Samad-Simprints/Vero-Firmware/README.md

# Scanner-Code
The Simprints Scanner Code
