Samad-Simprints/Vero-Firmware/hw/scanner/schematic/scanner_revB.xlsx

Top Level Revised: Tuesday, May 31, 2016
Index Scanner Iss 2 Revision: B
Fen Technology Ltd
Oakington Business Park
Oakington
Cambridge
CB24 3DQ
Bill Of Materials June 5,2016 17:37:55 | Page1
Item | Quantity | Reference | Part | Footprint | Manufacturer | Manufacturer's Part Number | Supplier | Supplier Part Number
______________________________________________
1 | 16 | C1,C2,C3,C4,C10,C14,C15, | 27pF/50V | 402 | Phycomp | CC0402JRNPO9BN270 | Farnell | 1816735
 |  | C32,C33,C34,C35,C36,C50,
 |  | C61,C62,C64
2 | 8 | C5,C6,C7,C8,C11,C12,C37, | 2.2uF, X5R | 402 | TDK | C1005X5R0J225K050BC | Farnell | 2346873
 |  | C39
3 | 29 | C9,C13,C16,C20,C21,C22, | 100nF/50V | 402 | TDK | CGA2B3X7R1H104K050 | Farnell | 2210822
 |  | C23,C24,C25,C26,C27,C28,
 |  | C29,C38,C40,C41,C42,C44,
 |  | C48,C52,C53,C54,C56,C57,
 |  | C59,C60,C63,C66,C69
4 | 1 | C17 | 10nF/50V | 402 | TDK | CGA2B3X7R1H103K050 | Farnell | 2210821
5 | 3 | C18,C67,C68 | 1nF/50V | 402 | TDK | CGA2B2X7R1H102K050BA | Farnell | 2210796
6 | 6 | C19,C46,C47,C55,C58,C65 | 10uF | 805 | TDK | C2012X5R0J106M | Farnell | 2309029
7 | 1 | C45 | 10nF/500V | 805 | Yageo | CC0805KKX7RBBB103 | Farnell | 1284130
8 | 2 | C49,C51 | 22uF | 805 | Taiyo Yuden | JMK212BJ226KG-T | Farnell | 2113069
9 | 1 | C70 | 1uF | 402 | multicomp | MC0402X105K6R3CT | Farnell | 1759375
10 | 1 | D1 | BLUE | LED_WURTH_WL-SMTW-150141BS73100 | Wurth | 150141BS73100 | Farnell | 2322105
11 | 6 | D2,D3,D4,D5,D6,D7 | WE-150141RV73100 | LED_WURTH_WL-SBTW-150141RV73100 | Wurth | 150141RV73100 | Farnell | 2322113
12 | 2 | D13,D15 | 1N4148W | SOD-123 | MULTICOMP | 1N4148W | Farnell | 1621821
13 | 4 | FB1,FB2,FB3,FB4 | 7427927291 | 402 | Wurth Elektronik | 7427927291 | Farnell | 1961694
14 | 1 | J1 | TC2050_IDC | TC2050IDC-NL | Tag_connect | TC2050IDC-NL | NA | NA
15 | 1 | J2 | Molex 12W FFC 0.5mm | CONN_MOLEX_52746-12WAY | Molex | 52746-1271 | Farnell | 2060699
16 | 1 | J3 | 1054431101 | CONN_USB-AB_MOLEXWP_SD105443-110_0.65P | Molex | 1054431101 | Farnell | 2500017
17 | 1 | J4 | 53261-0371 | CONN_MOLEX_53261-3WAY_RA | Molex | 53261-0371 | Farnell | 1125359
18 | 1 | L1 | 600R/1A | 742792651 | Wurth Elektronik | 742792651 | Farnell | 1635706
19 | 2 | L2,L5 | 744231091 | 744231091 | Wurth Elektronik | 744231091 | Farnell | 1636469
20 | 4 | L3,L4,L6,L9 | WE-CBF_742792651 | WE-CBF_742792651 | Wurth | 742792651 | Farnell | 1635706
21 | 1 | L7 | 3.3uH/0.65A | IND_744030003 | Wurth | 744030003 | Farnell | 2211437
22 | 1 | L8 | 3.3uH/2A | IND_COILCRAFT_LPS4018_3.9X3.9_1.8H | Coilcraft | LPS4018-332MRC | Mouser | 994-LPS4018-332MRC
23 | 1 | Q1 | FDC6420 | SOT23-6L | Fairchild | FDC6420C | RS | 903-4147
24 | 1 | Q2 | IRLML0030TRPBF | SOT23-132 | IR | IRLML0030TRPBF | Farnell | 1791366
25 | 2 | Q3,Q11 | BC857C | SOT23-132 | NXP | BC857C | Farnell | 8734771
26 | 7 | Q4,Q5,Q6,Q7,Q8,Q9,Q10 | MUN5211DW | SOT363 | On Semi | MUN5211DW1T1G | Farnell | 2317633
27 | 1 | R1 | 15R | 603 | Yageo | RC0603JR-0715RL | Farnell | 9233156
28 | 11 | R3,R5,R15,R35,R75,R79, | 100K | 402 | Multicomp | MC 0.0625W 0402 1% 100K | Farnell | 1358096
 |  | R80,R82,R102,R106,R107
29 | 25 | R6,R8,R10,R16,R18,R19, | 10K | 402 | Multicomp | MC 0.0625W 0402 1% 10K | Farnell | 1358069
 |  | R21,R22,R23,R24,R26,R29,
 |  | R30,R40,R43,R44,R45,R46,
 |  | R49,R59,R78,R101,R104,
 |  | R105,R110
30 | 2 | R11,R12 | 2K2 | 402 | Multicomp | MC 0.0625W 0402 1% 2K2 | Farnell | 1358051
31 | 1 | R13 | 12K | 402 | Multicomp | MC 0.0625W 0402 1% 12K | Farnell | 1358071
32 | 2 | R14,R77 | 1K5 | 402 | Multicomp | MC 0.0625W 0402 1% 1K5 | Farnell | 1358047
33 | 5 | R17,R20,R27,R97,R98 | 22R | 402 | Multicomp | MC 0.0625W 0402 1% 22R | Farnell | 1357998
34 | 1 | R28 | 0.01R | 603 | Vishay Dale | WSL0603R0100FEA | Farnell | 2112794
35 | 5 | R31,R32,R99,R100,R108 | 15K | 402 | Multicomp | MC 0.0625W 0402 1% 15K | Farnell |  | 1358073
36 | 3 | R33,R39,R50 | DNF | 402
37 | 1 | R34 | 1M/400V | 805 | Welwyn | LHVC0805-1MFT5 | Farnell | 1506149
38 | 2 | R36,R81 | 332K | 402 | Multicomp | MC 0.0625W 0402 1% 332K | Farnell | 1803798
39 | 1 | R37 | 75K | 402 | Multicomp | MC 0.0625W 0402 1% 75K | Farnell | 1358093
40 | 1 | R38 | 6K2 | 402 | Multicomp | MC 0.0625W 0402 1% 6K2 | Farnell | 1358063
41 | 4 | R41,R42,R51,R52 | 1M | 402 | Multicomp | MC 0.0625W 0402 1% 1M | Farnell | 1358123
42 | 1 | R47 | 3K3 | 402 | Multicomp | MC 0.0625W 0402 1% 3K3 | Farnell | 2130392
43 | 1 | R48 | 2K | 402 | Multicomp | MC 0.0625W 0402 1% 2K | Farnell | 1358050
44 | 12 | R53,R54,R55,R56,R57,R58, | 56R | 603 | Multicomp | MC 0.0625W 0603 1% 56R | Farnell | 9331387
 |  | R60,R61,R62,R63,R65,R66
45 | 2 | R76,R103 | 470R | 402 | Multicomp | MC 0.0625W 0402 1% 470R | Farnell | 1358034
46 | 1 | R109 | 33K | 402 | Multicomp | MC 0.0625W 0402 1% 33K | Farnell |  | 2130474
47 | 1 | SW1 | MCDHN-02F-V | SW_MULTICOMP_MCDHN_2WAY_3.8X4.5 | Multicomp |  | Farnell
48 | 2 | S1,S2 | SKRAALE010 | SW_ALPS_SKRAALE010_6.2X6.2_3.4H | ALPS | SKRAALE010 | Farnell | 2056845
49 | 30 | TPVIA2,TPVIA6,TPVIA7, | TPVIA | TPVIA
 |  | TPVIA8,TPVIA9,TPVIA10,
 |  | TPVIA11,TPVIA12,TPVIA13,
 |  | TPVIA14,TPVIA15,TPVIA16,
 |  | TPVIA17,TPVIA18,TPVIA19,
 |  | TPVIA20,TPVIA21,TPVIA22,
 |  | TPVIA23,TPVIA24,TPVIA25,
 |  | TPVIA26,TPVIA27,TPVIA28,
 |  | TPVIA29,TPVIA30,TPVIA31,
 |  | TPVIA32,TPVIA33,TPVIA34
50 | 17 | TP1,TP2,TP3,TP4,TP5,TP6, | TP_DFM_NOFILL | TP_DFM
 |  | TP7,TP8,TP9,TP10,TP11,
 |  | TP12,TP13,TP14,TP15,TP16,
 |  | TP17
51 | 1 | U1 | BTM805CL2B | MODULE_FLAIRCOMM-FLCBTM805 | FlairMicro | BTM805CL2B | BCD | BTM805CL2B
52 | 1 | U2 | LPC1833_LBGA256 | BGA256C100P16X16_1700X1700X155 | NXP | LPC1833JET256 | DigiKey | LPC1833JET256,551-ND
53 | 1 | U3 | STM809RWX6F | SOT23-132 | ST Microelectronics | STM809RWX6F | Farnell | 8690413
54 | 1 | U4 | AT45DB161E-SSHD-B | SOIC8 | Adesto | AT45DB161E-SSHD-B | Farnell | 2136671
55 | 1 | U5 | SN74LVC1G74DCU | SO8_2.0X2.4_0.5 | TI | SN74LVC1G74DCU | Farnell | 2295725
56 | 1 | U6 | MIC94093YC6 | SC70-6 | Microchip | MIC94093YC6 | Mouser | 998-MIC94093YC6TR
57 | 1 | U7 | 82400102 | SOT23-6L | Wurth Elektronik | 82400102 | Farnell | 1825875
58 | 1 | U8 | LTC3542EDC | DFN_6_2X2_SLUG | Linear Tech | LTC3542EDC | Farnell | 1715237
59 | 1 | U9 | LTC4160 | QFN20_3X4_WITH_SLUG_0.75H | Linear Tech | LTC4160EUDC | DigiKey | LTC4160EUDC#PBF-ND
60 | 1 | U10 | SN74LVC1G06DBVR | SOT23-5 | TI | SN74LVC1G06DBVR | Farnell | 1105928
61 | 2 | U11,U14 | TS3USB221EDRCR | QFN10_3X3_0.5_SLUG | TI | TS3USB221EDRCR | Farnell | 2383155
62 | 1 | U12 | LTC2941CDCB | DFN_6_2X3_SLUG | Linear Tech | LTC2941CDCB#TRMPBF | DigiKey | LTC2941CDCB#TRMPBFCT-ND
63 | 1 | VIB1 | DNF | VIBRO_JINLONG_C1027H300F | Jinlong | C1027H300F | ?
64 | 1 | Y1 | 12.00MHz | TXC_2.5X3.2 | TXC | 7M-12.000MAAJ-T | Farnell | 1842056
