Samad-Simprints/Vero-Firmware/fw/installation/README.md

# Manufacturing-LPC-Script
A collection of scripts that will be used in the manufacture of Simprints fingerprint scanners (SFS).
