Samad-Simprints/Vero-Firmware/hw/scanner/schematic/scanner_revc.pdf

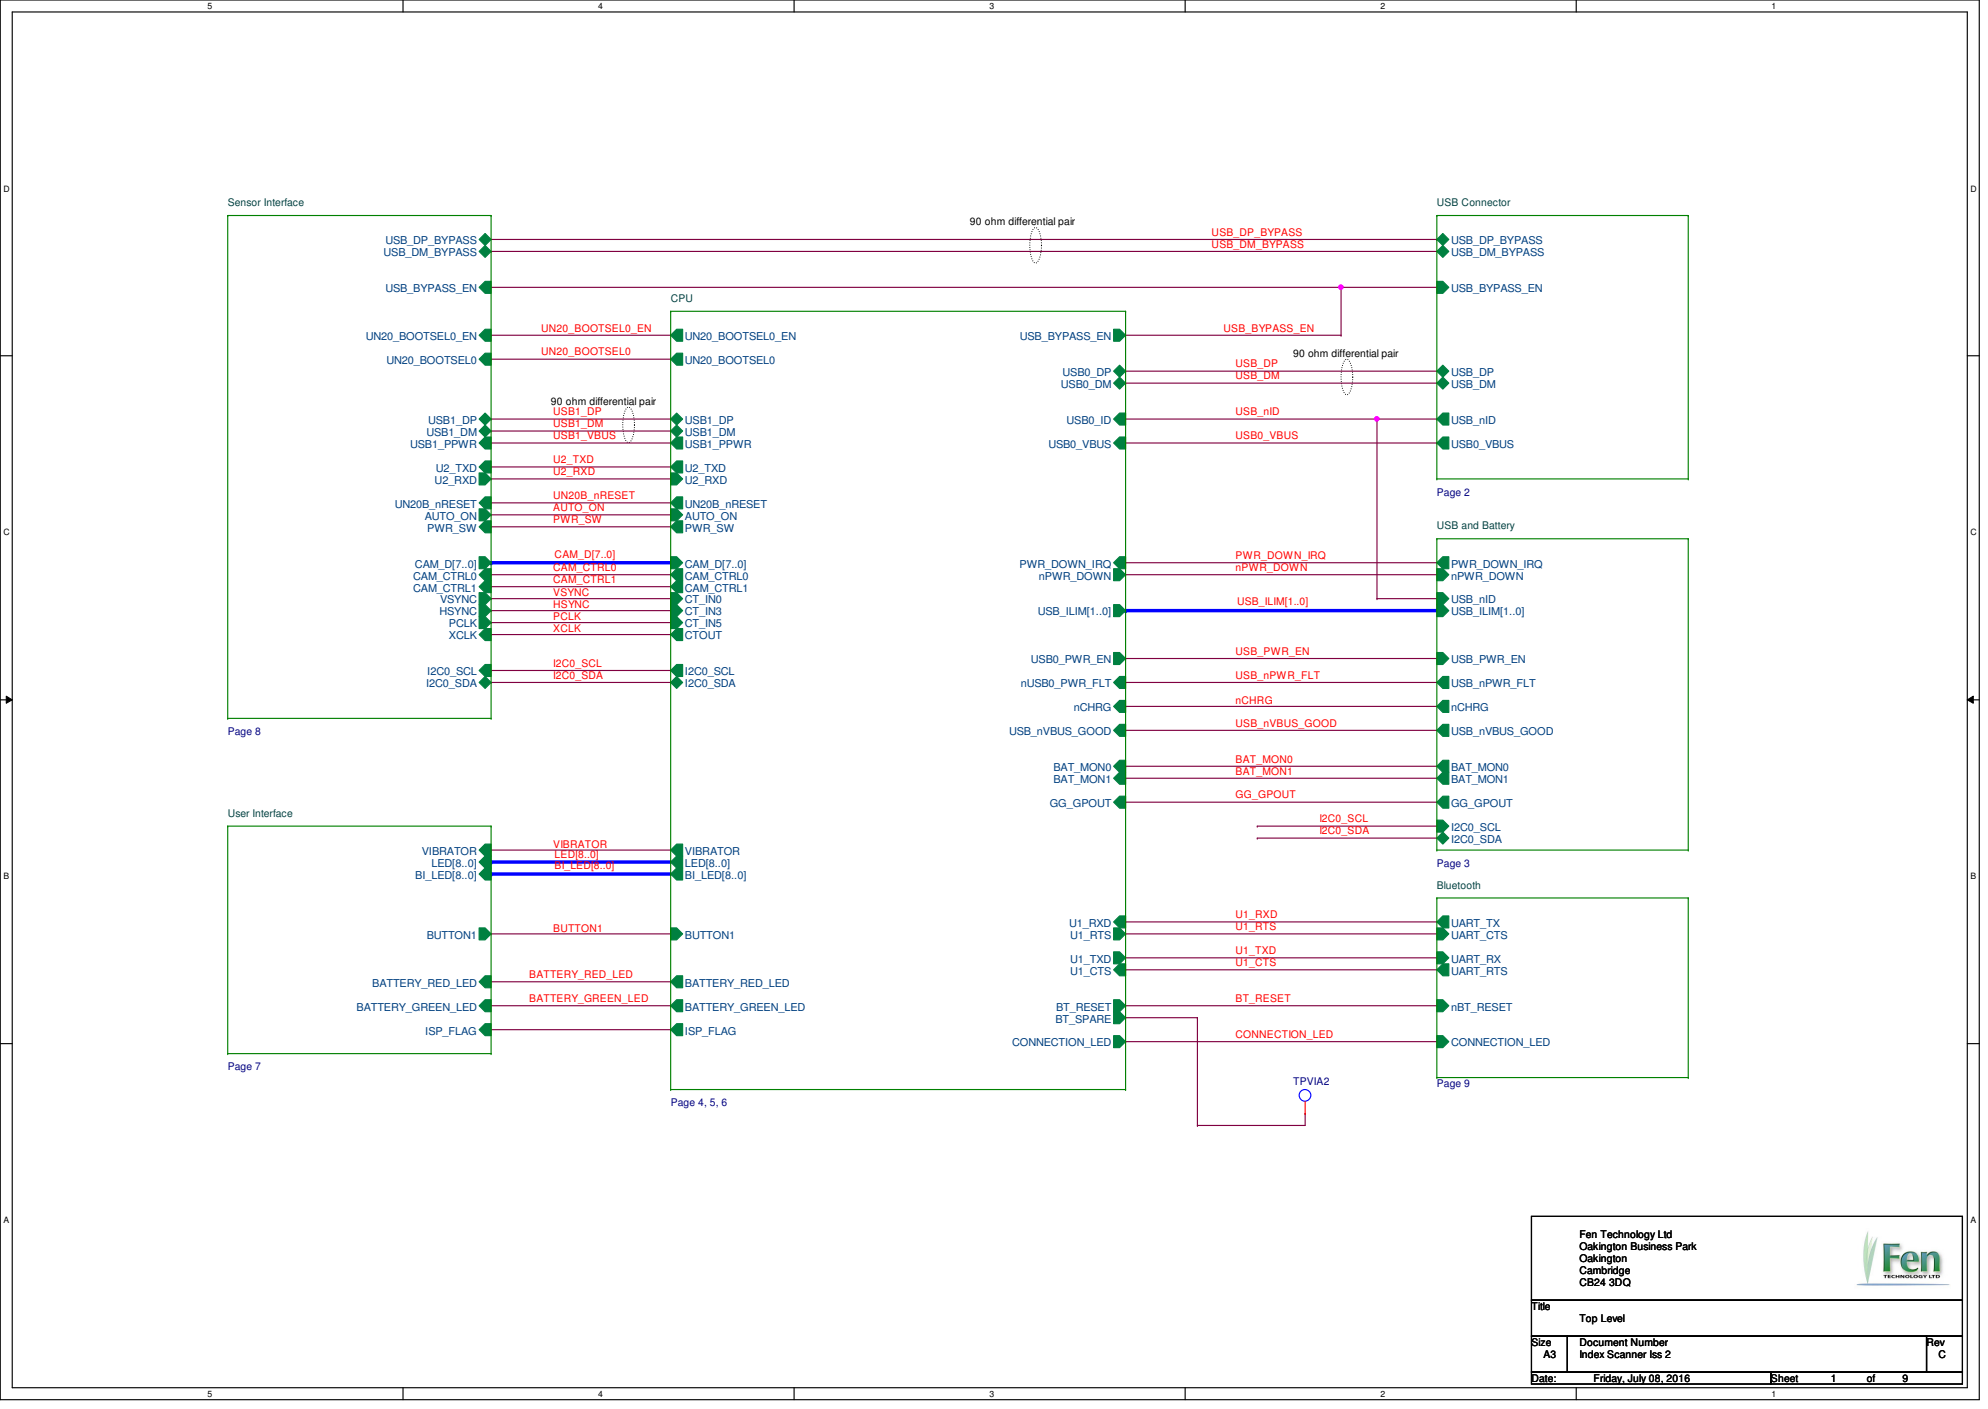
[picture p1: page 1]
90 ohm differential pair; U1_RXD U1_RTS; U1_TXD U1_CTS; BT_RESET; USB1_DP USB1_DM USB1_VBUS; U2_TXD U2_RXD; UN20B_nRESET AUTO_ON PWR_SW; CAM_D[7..0]; VSYNC HSYNC PCLK XCLK; I2C0_SCL I2C0_SDA; LED[8..0]; VIBRATOR; BUTTON1; BI_LED[8..0]; CONNECTION_LED; BATTERY_RED_LED; USB_DM; USB_DP; USB_nID; PWR_DOWN_IRQ; BAT_MON0 BAT_MON1; USB_nPWR_FLT; USB_nVBUS_GOOD; USB_PWR_EN; USB0_VBUS; nCHRG; UN20_BOOTSEL0_EN; UN20_BOOTSEL0; USB_BYPASS_EN; USB_DP_BYPASS USB_DM_BYPASS; BATTERY_GREEN_LED; GG_GPOUT; Title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

90 ohm differential pair

USB and Battery

CAM_CTRL0 | nPWR_DOWN
CAM_CTRL1 | USB_ILIM[1..0]

Fen Technology Ltd
Oakington Business Park
Oakington
Cambridge

## UART_TX

## UART_RX

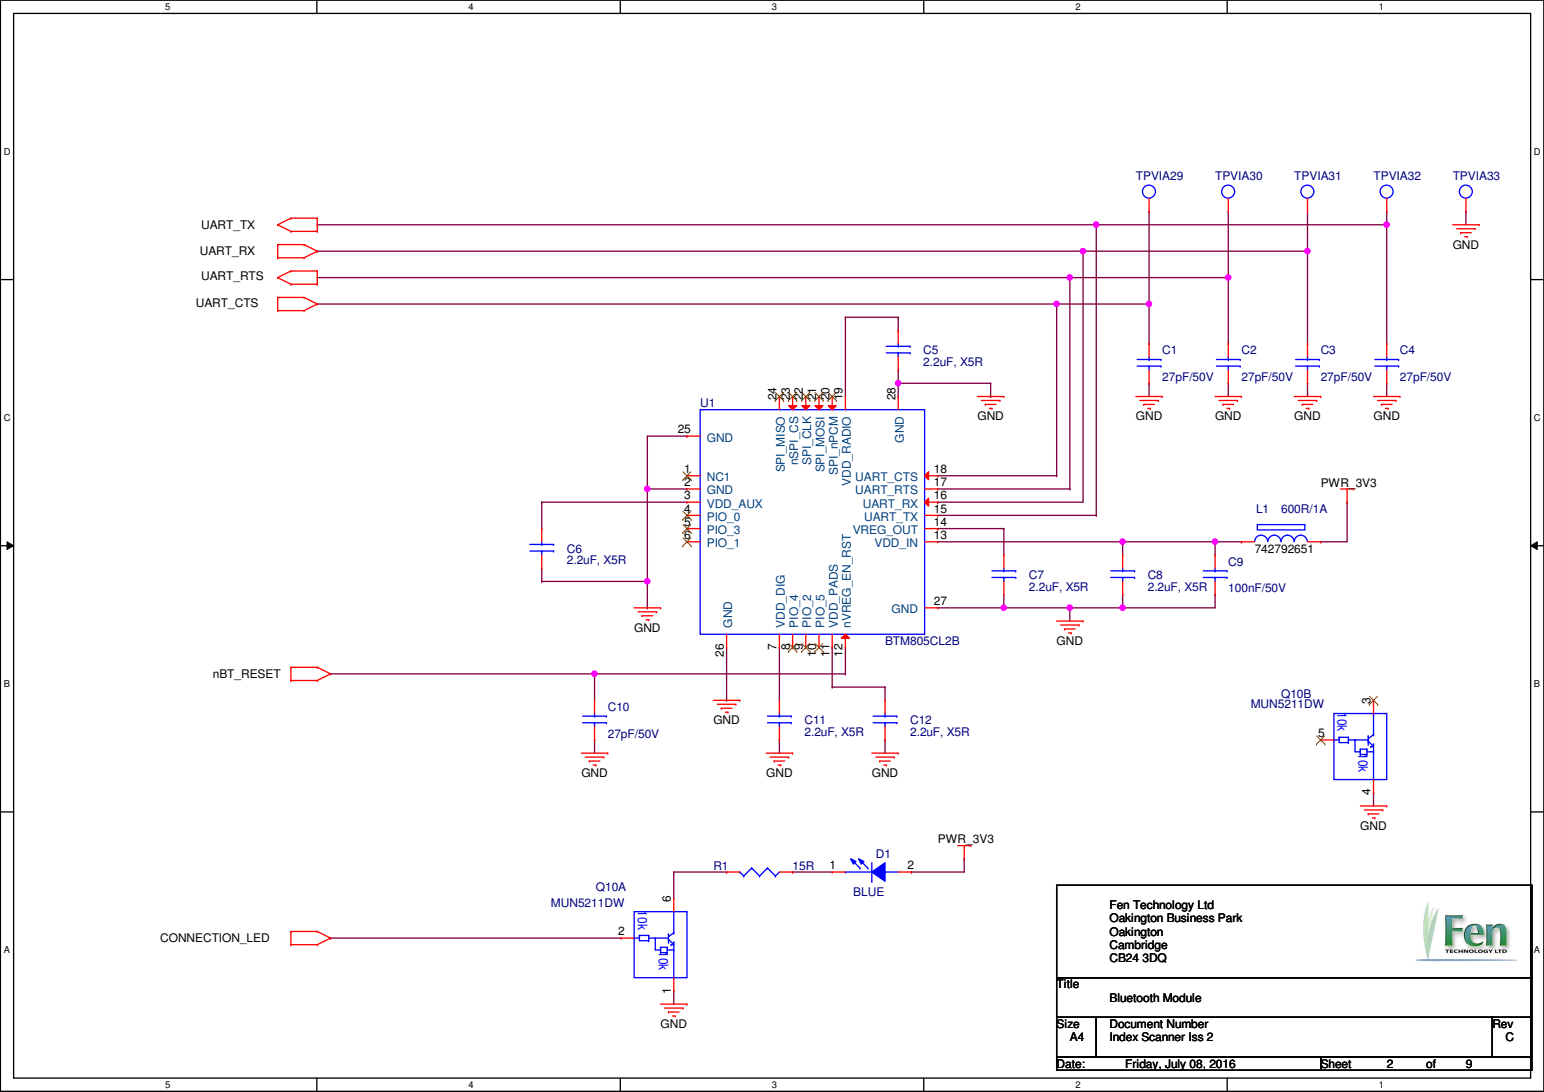
[picture p2: page 2]

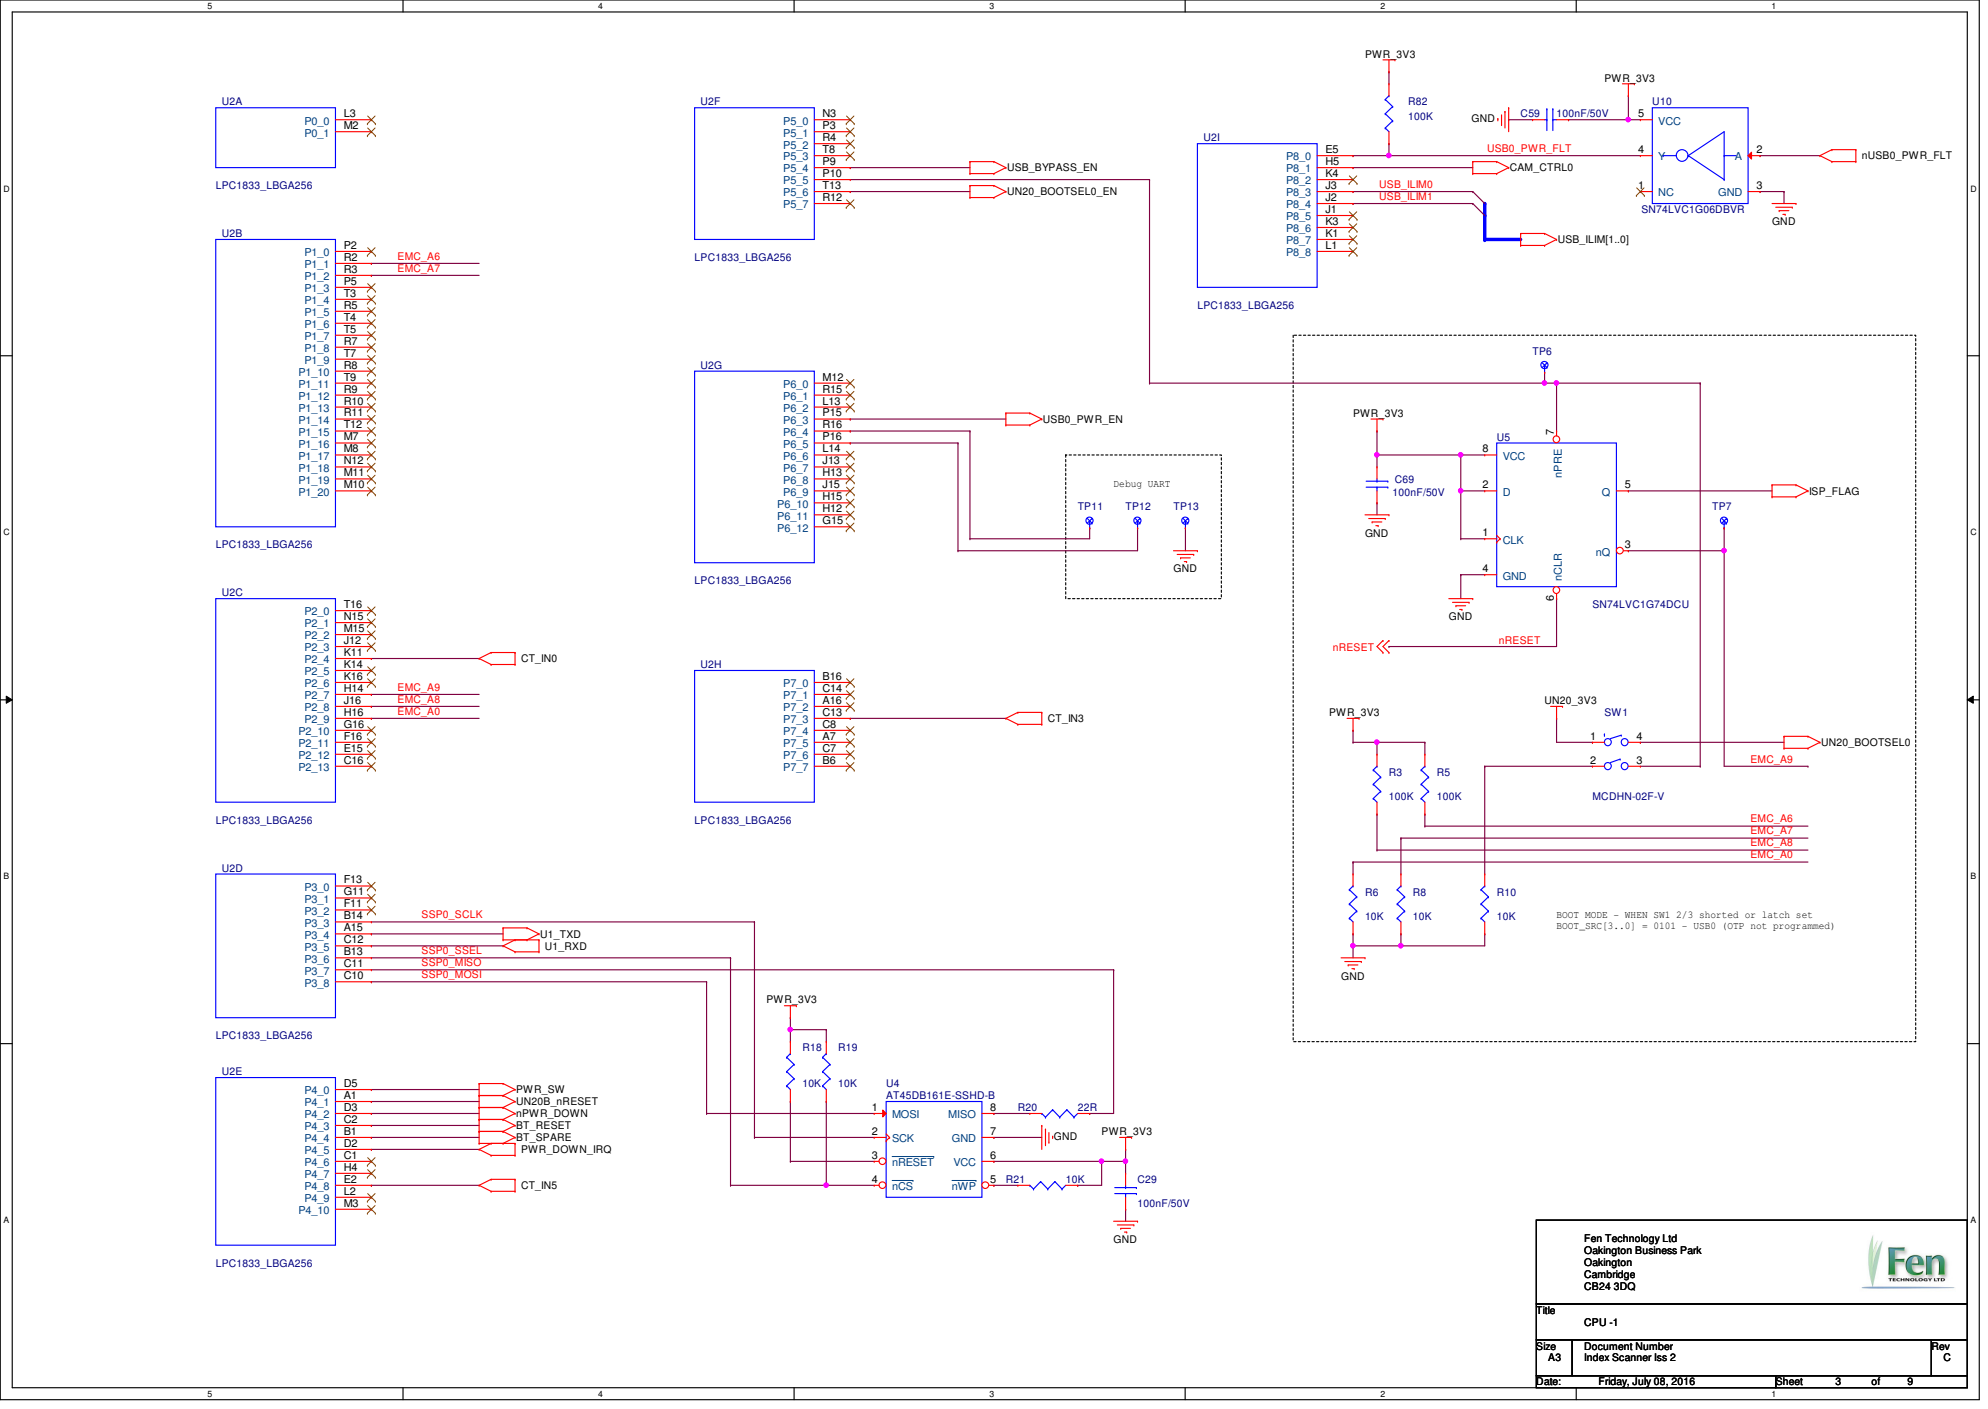
[picture p3: page 3]

BOOT MODE - WHEN SW1 2/3 shorted or latch set
BOOT_SRC[3..0] = 0101 - USB0 (OTP not programmed)

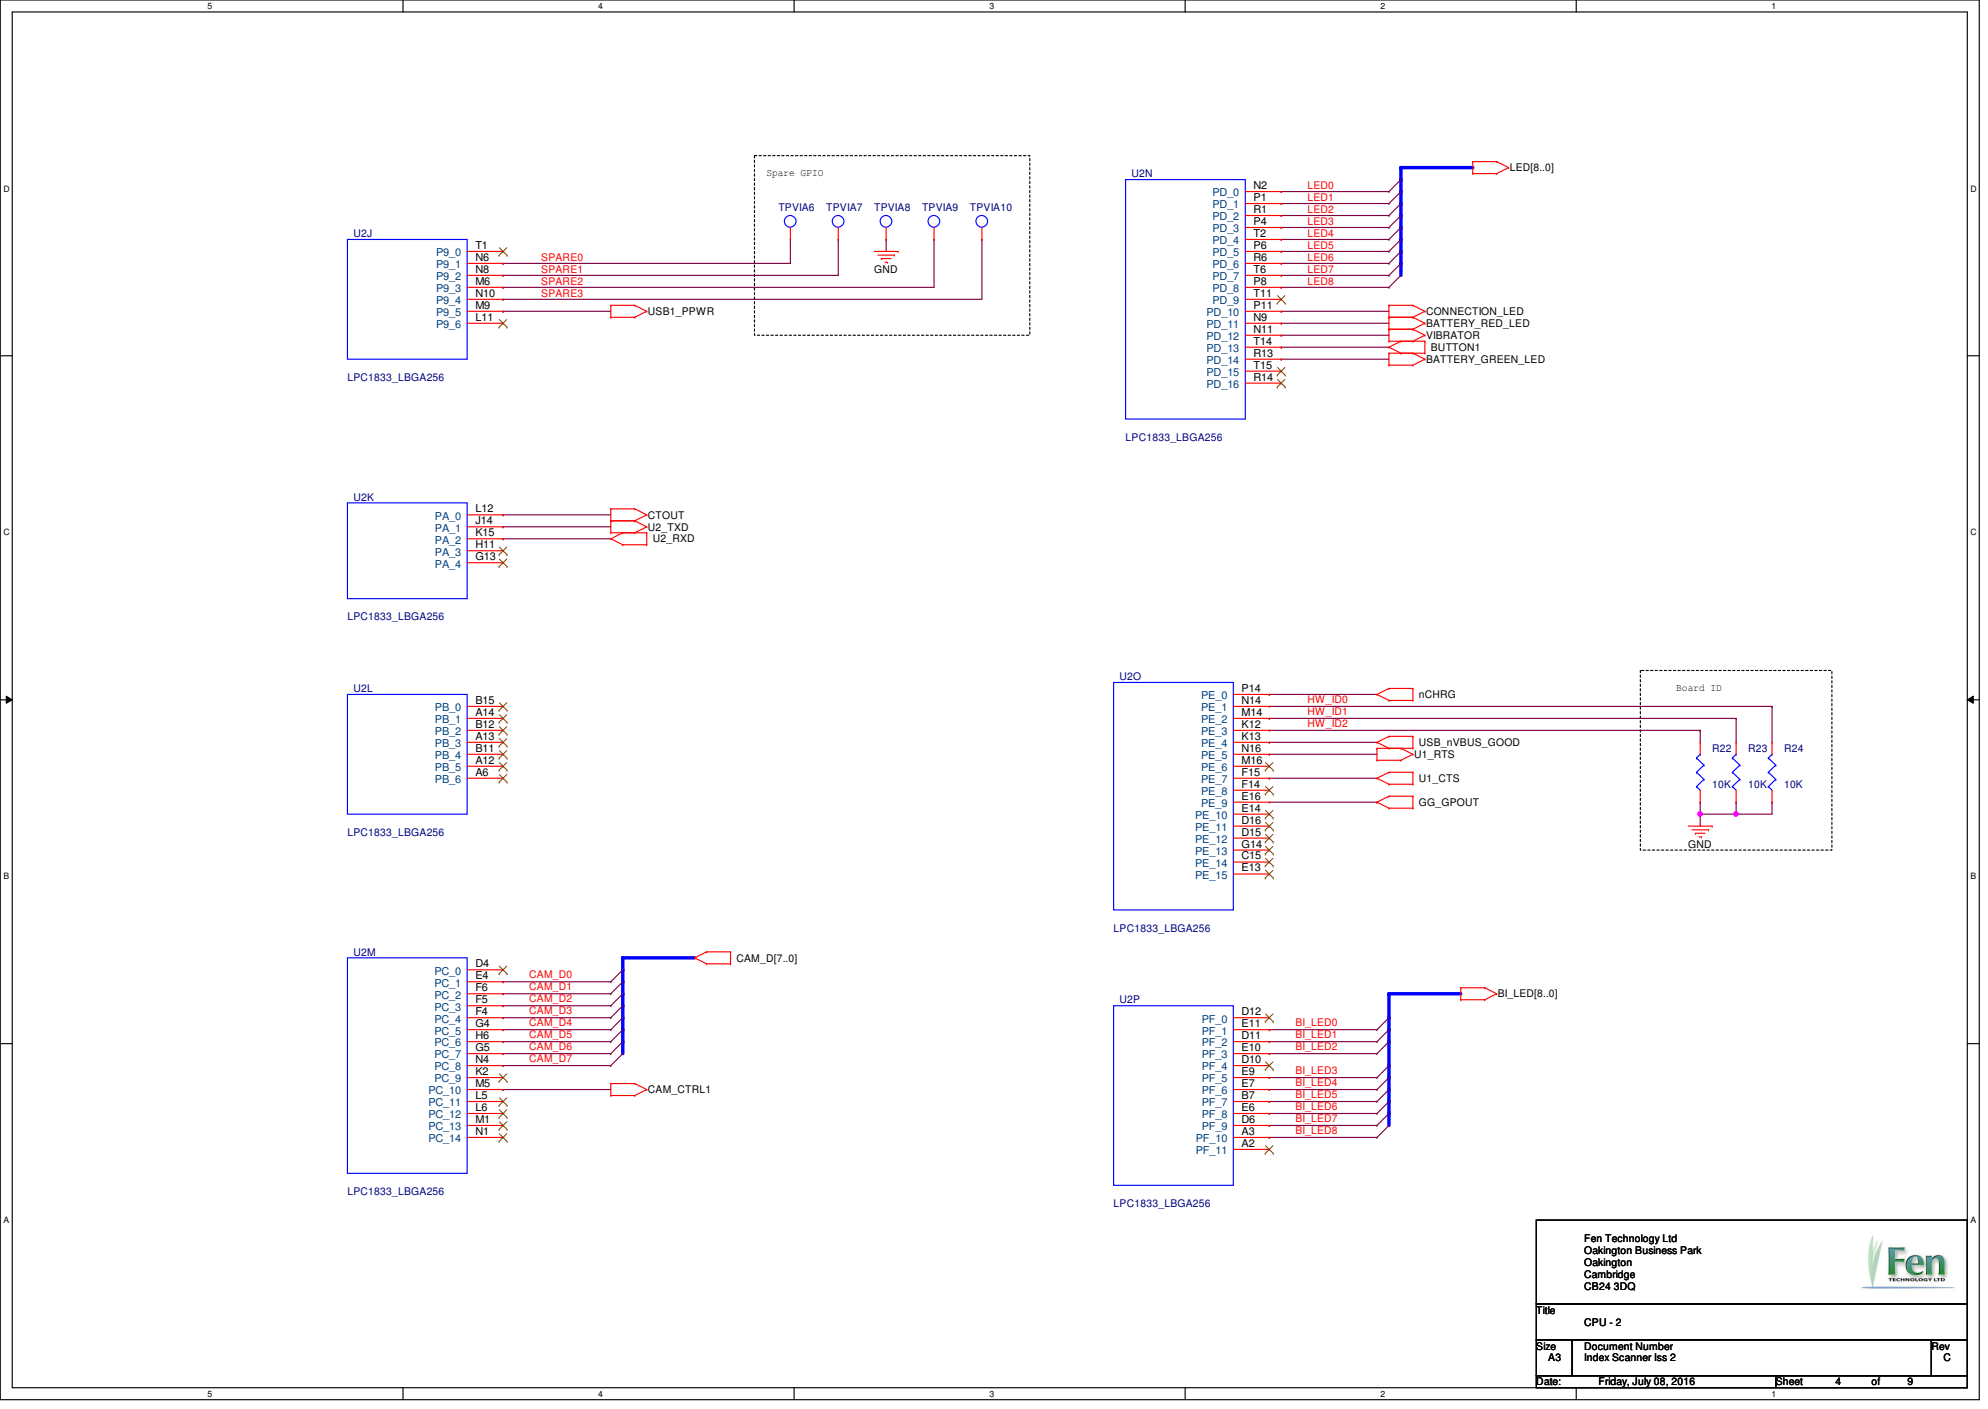
[picture p4: page 4]

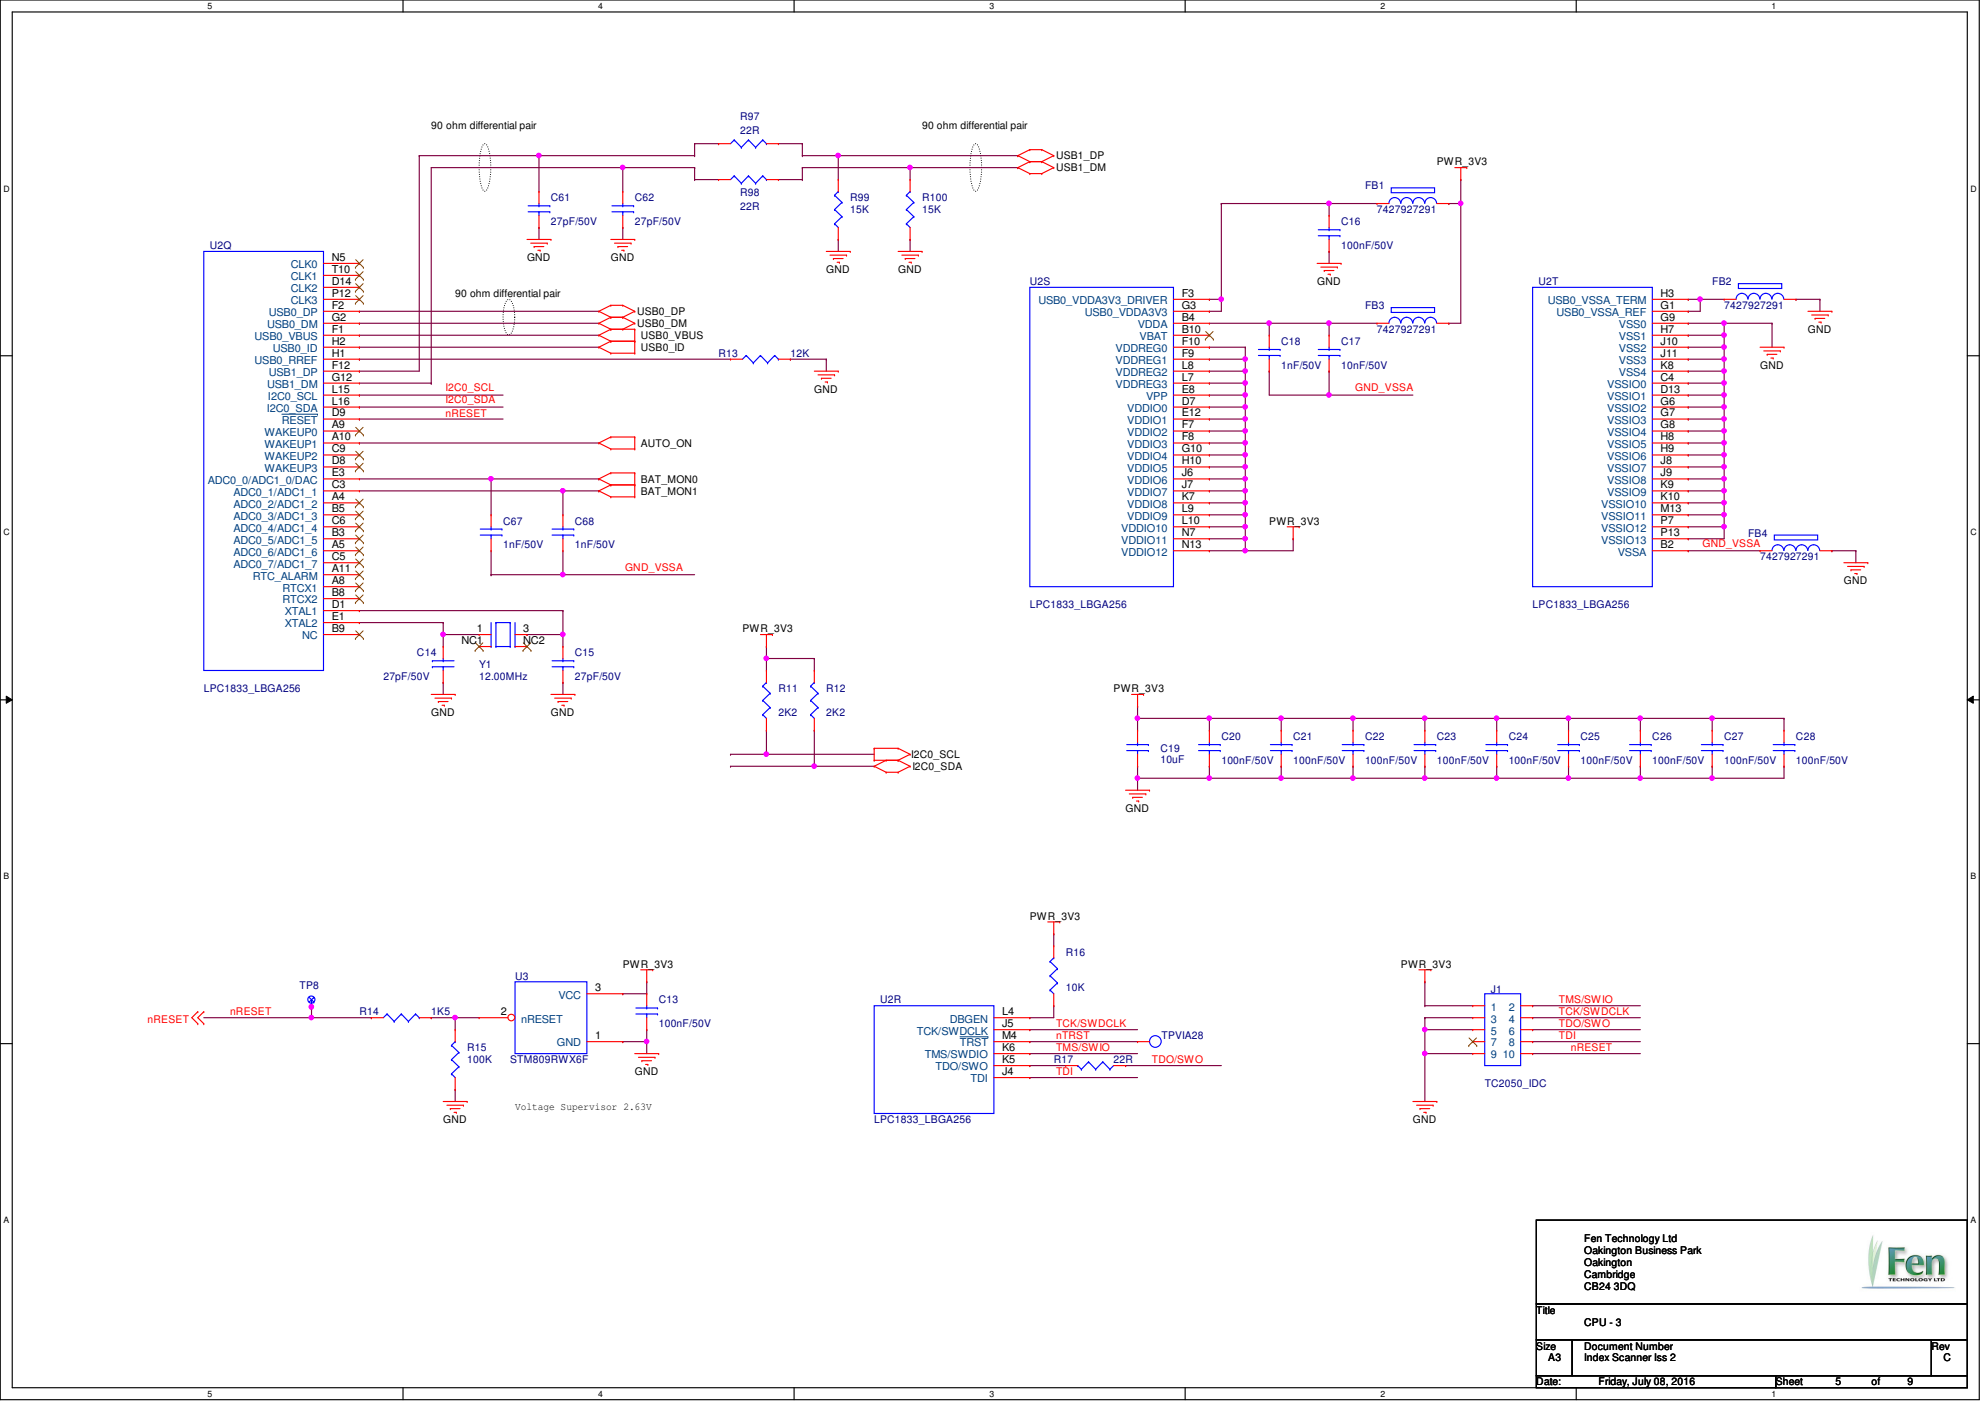
[picture p5: page 5]

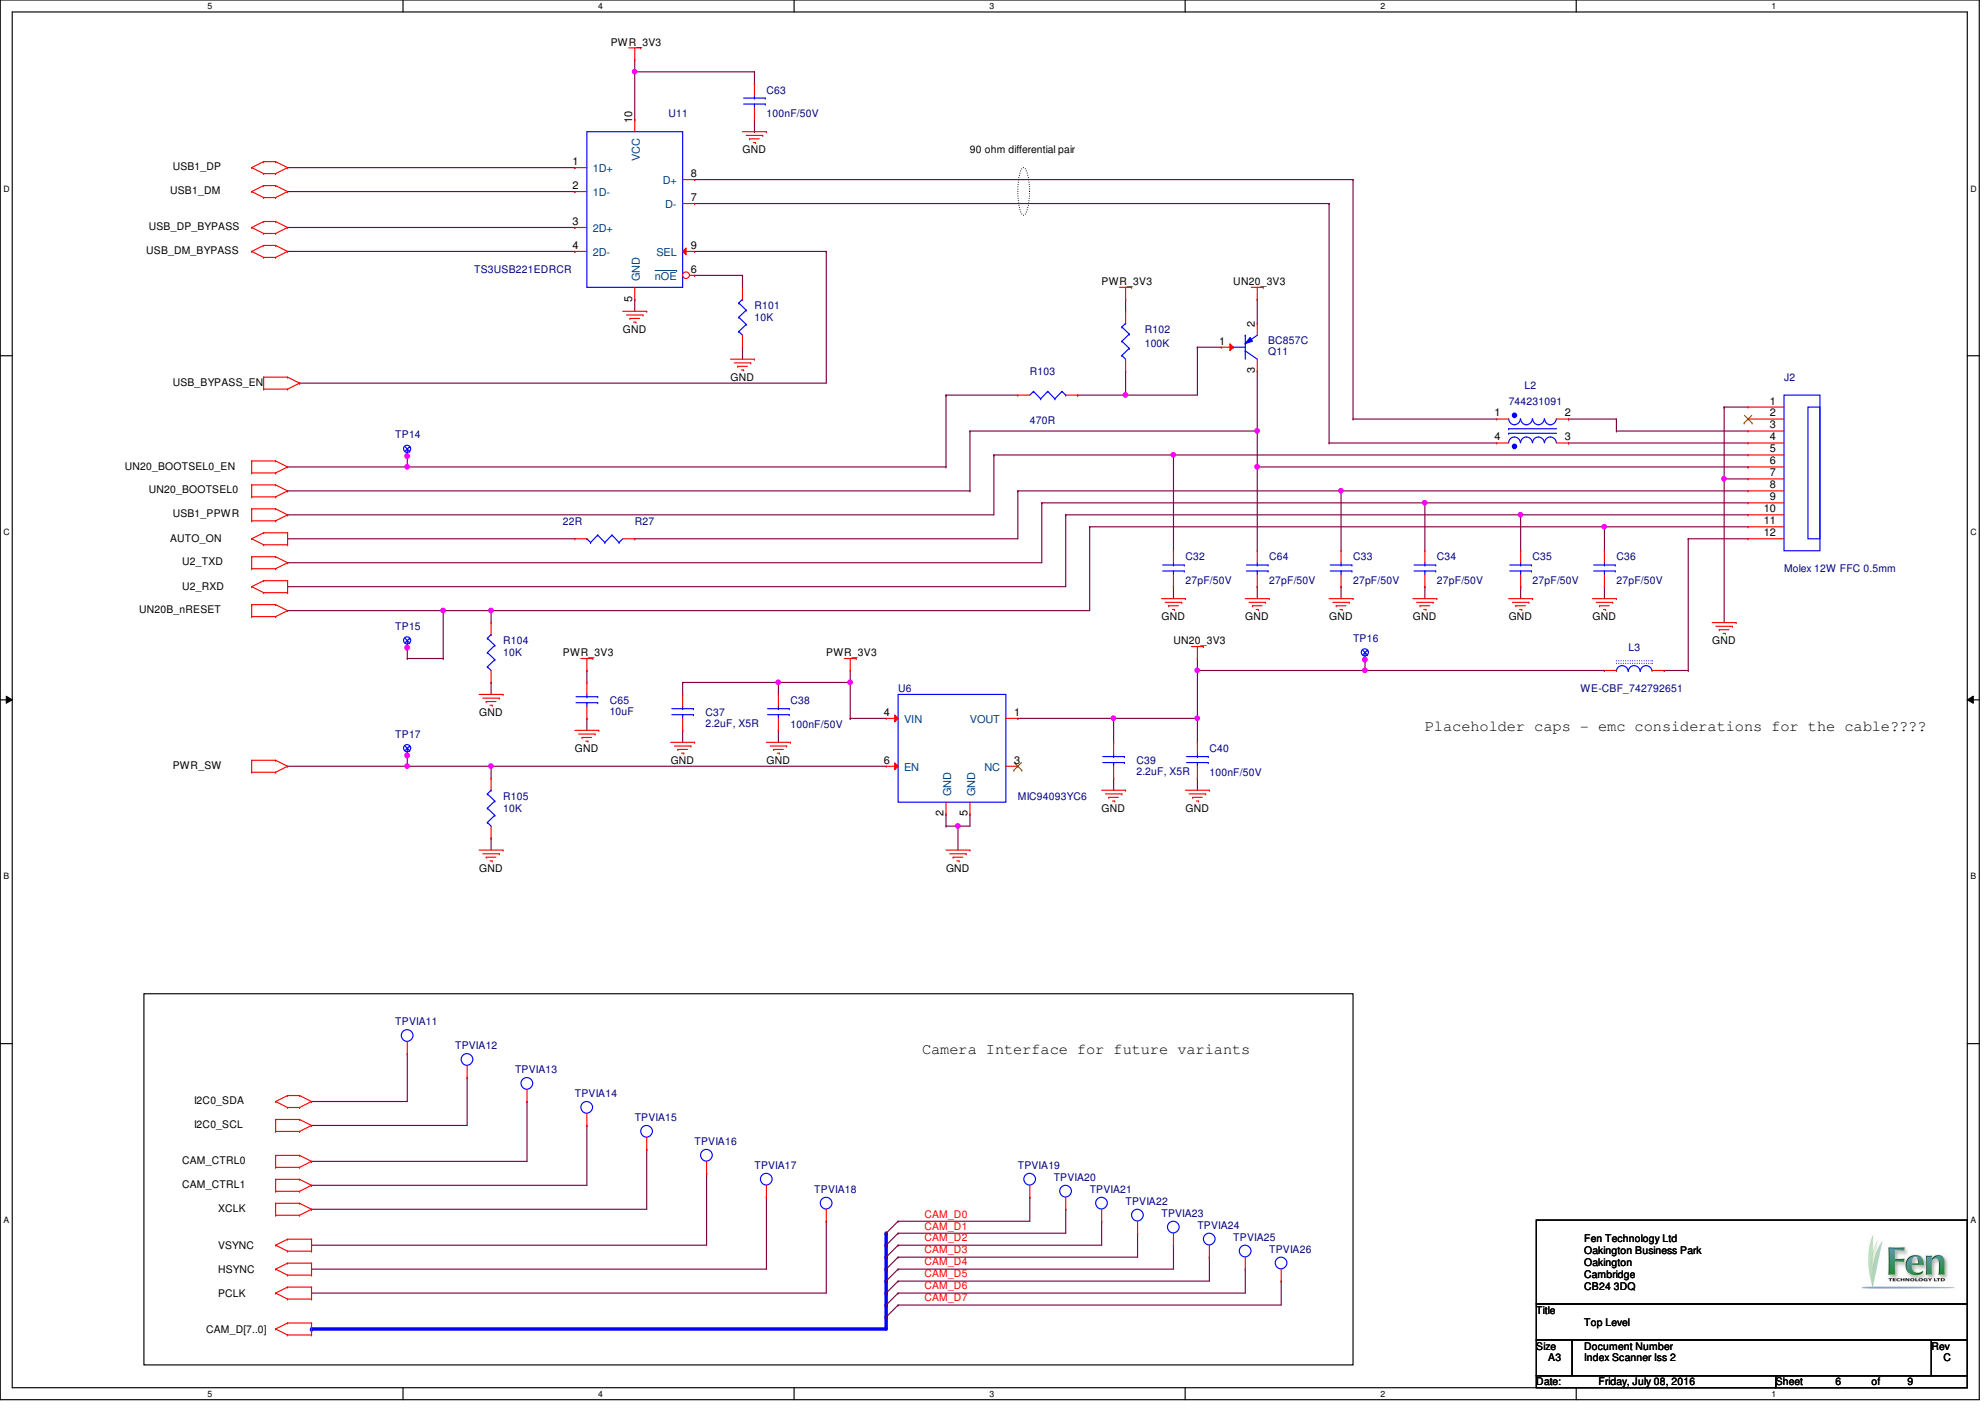
[picture p6: page 6]

Placeholder caps - emc considerations for the cable????

Camera Interface for future variants

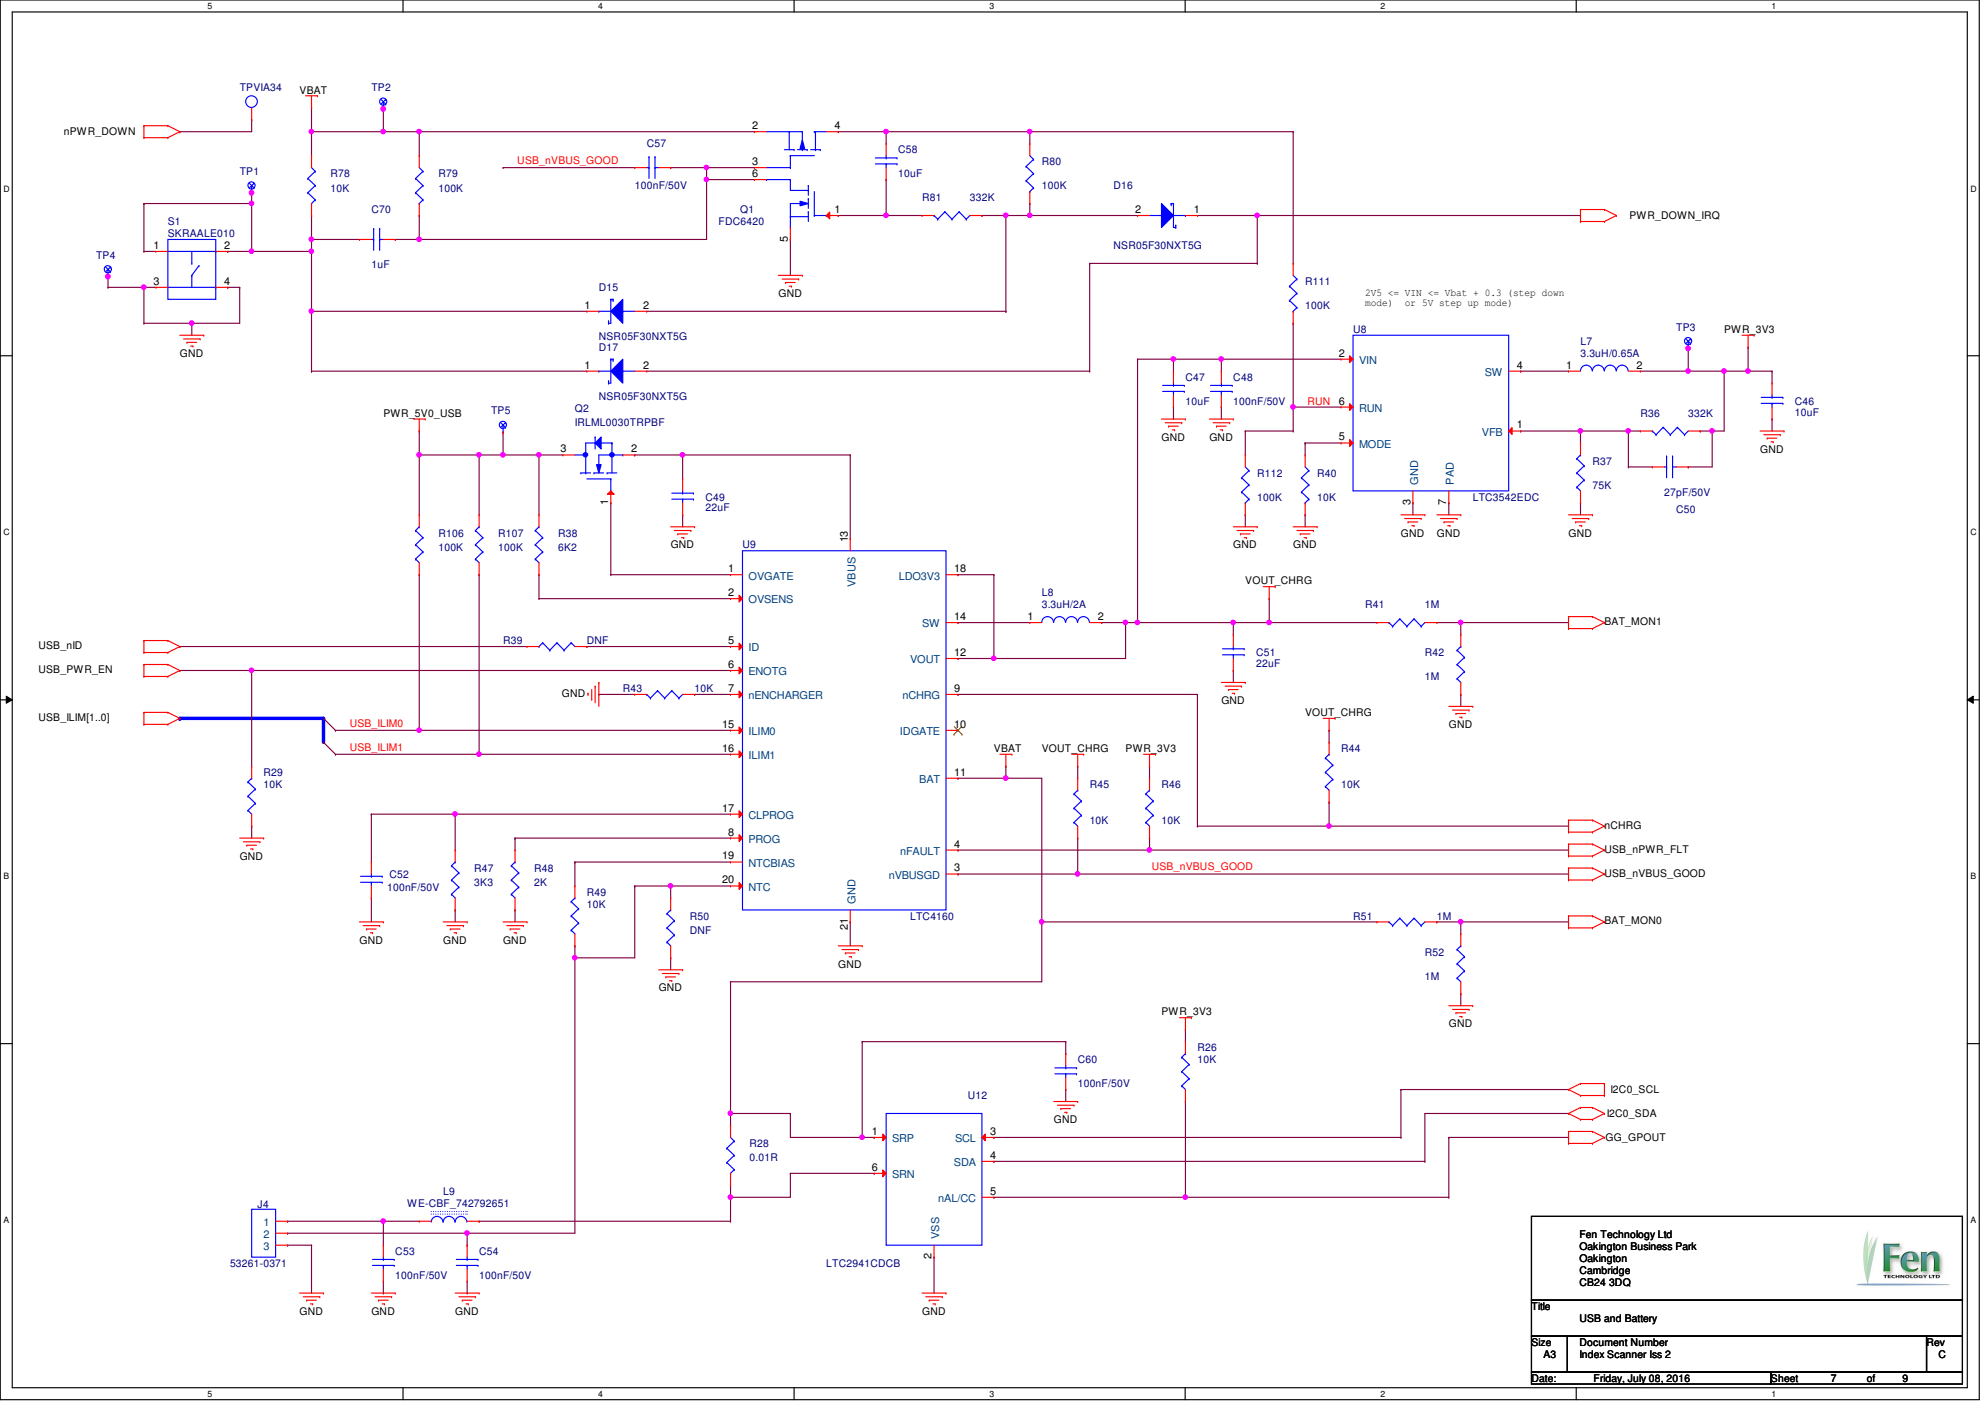
[picture p7: page 7]

2V5 <= VIN <= Vbat + 0.3 (step down

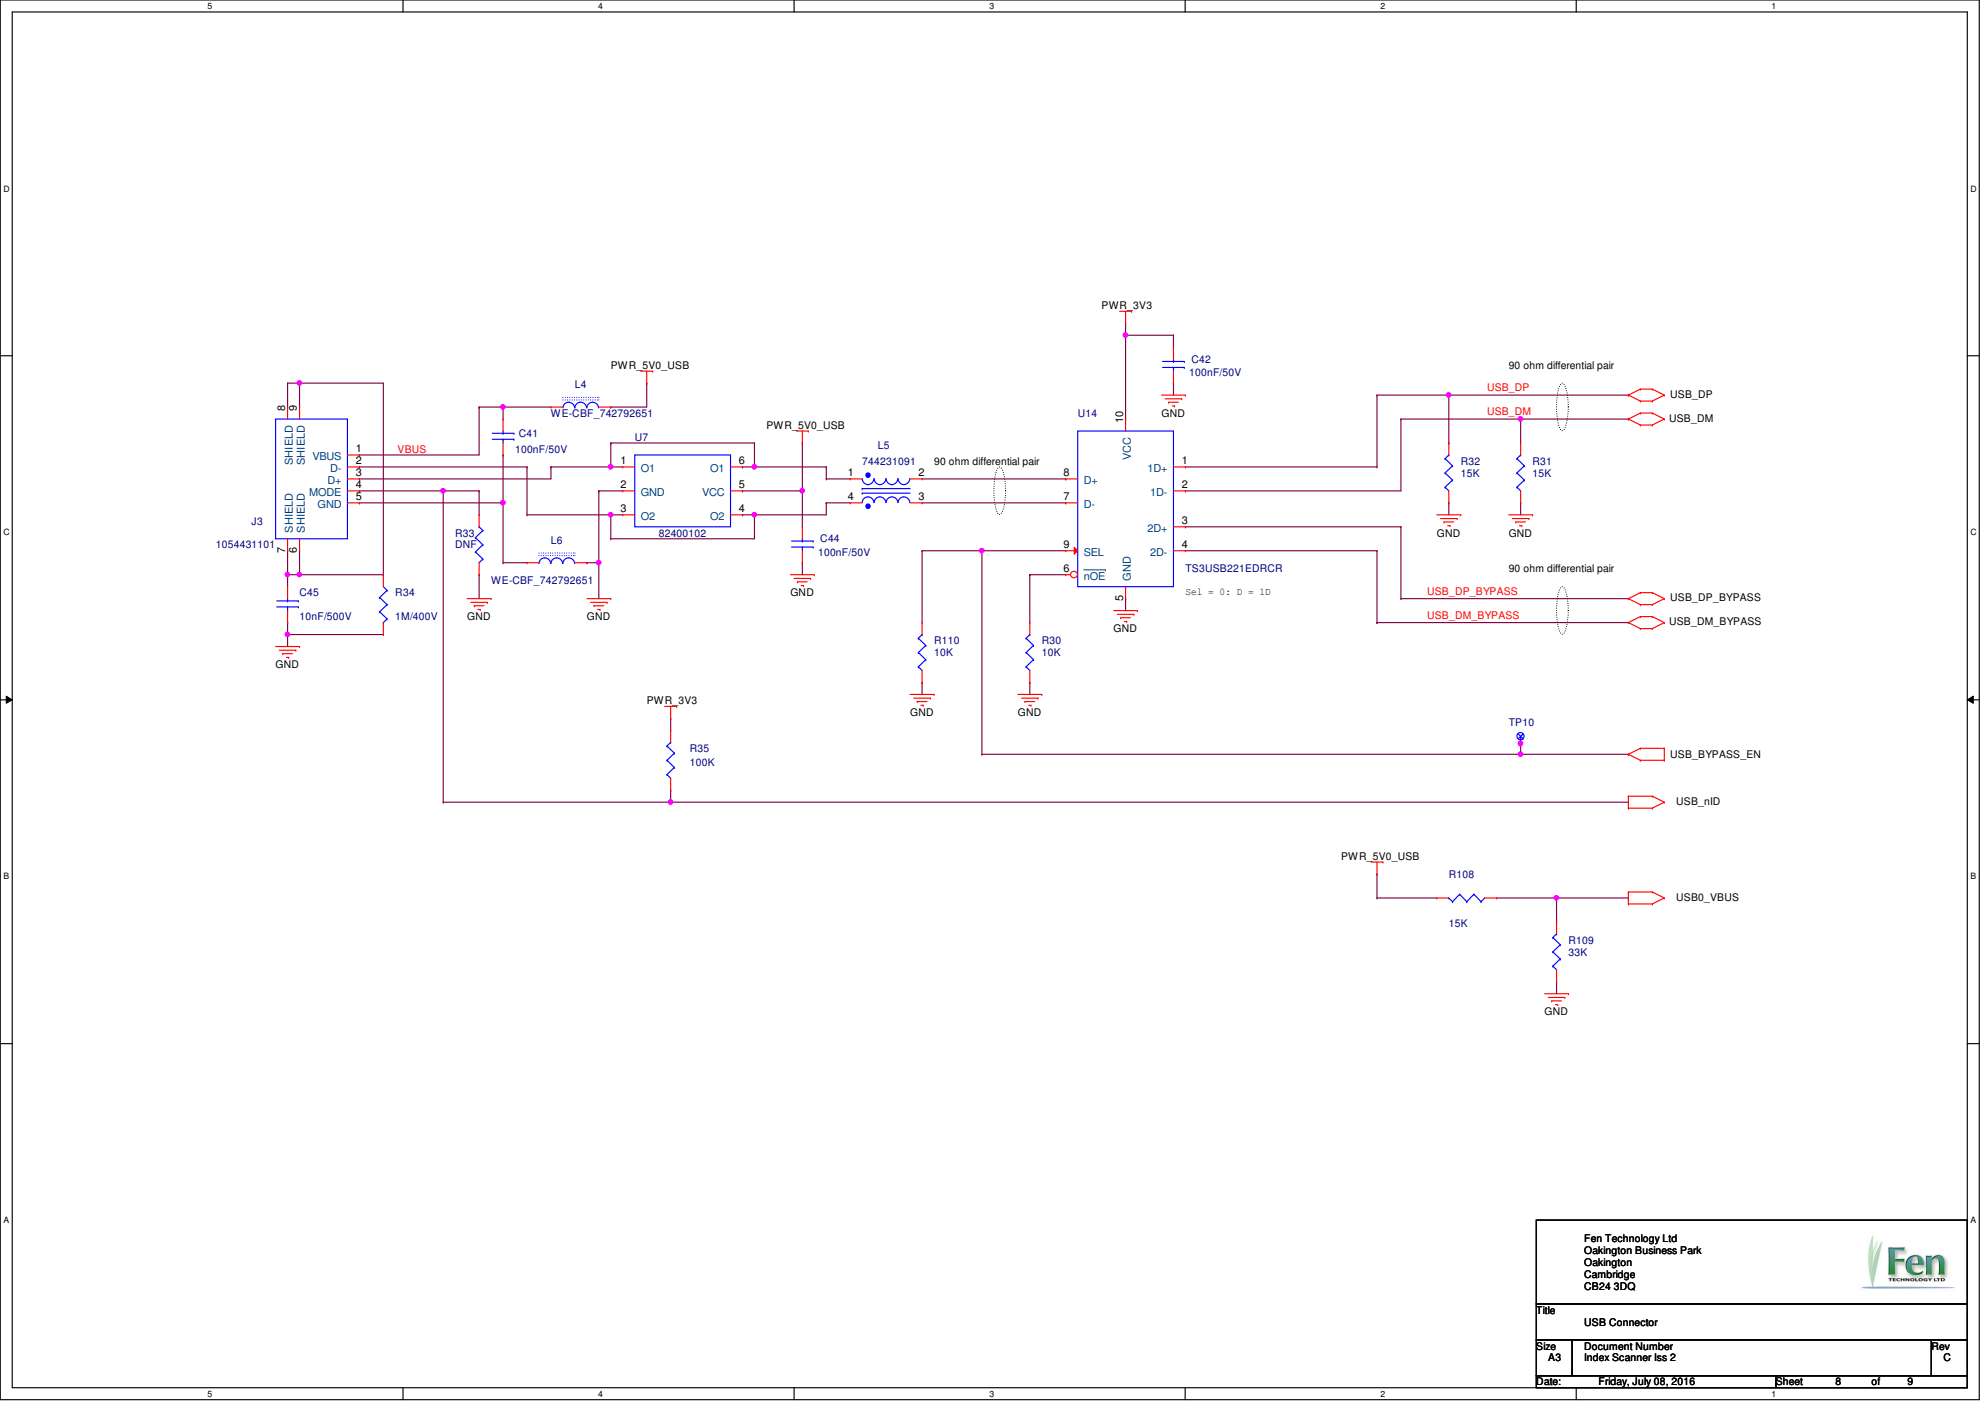
[picture p8: page 8]

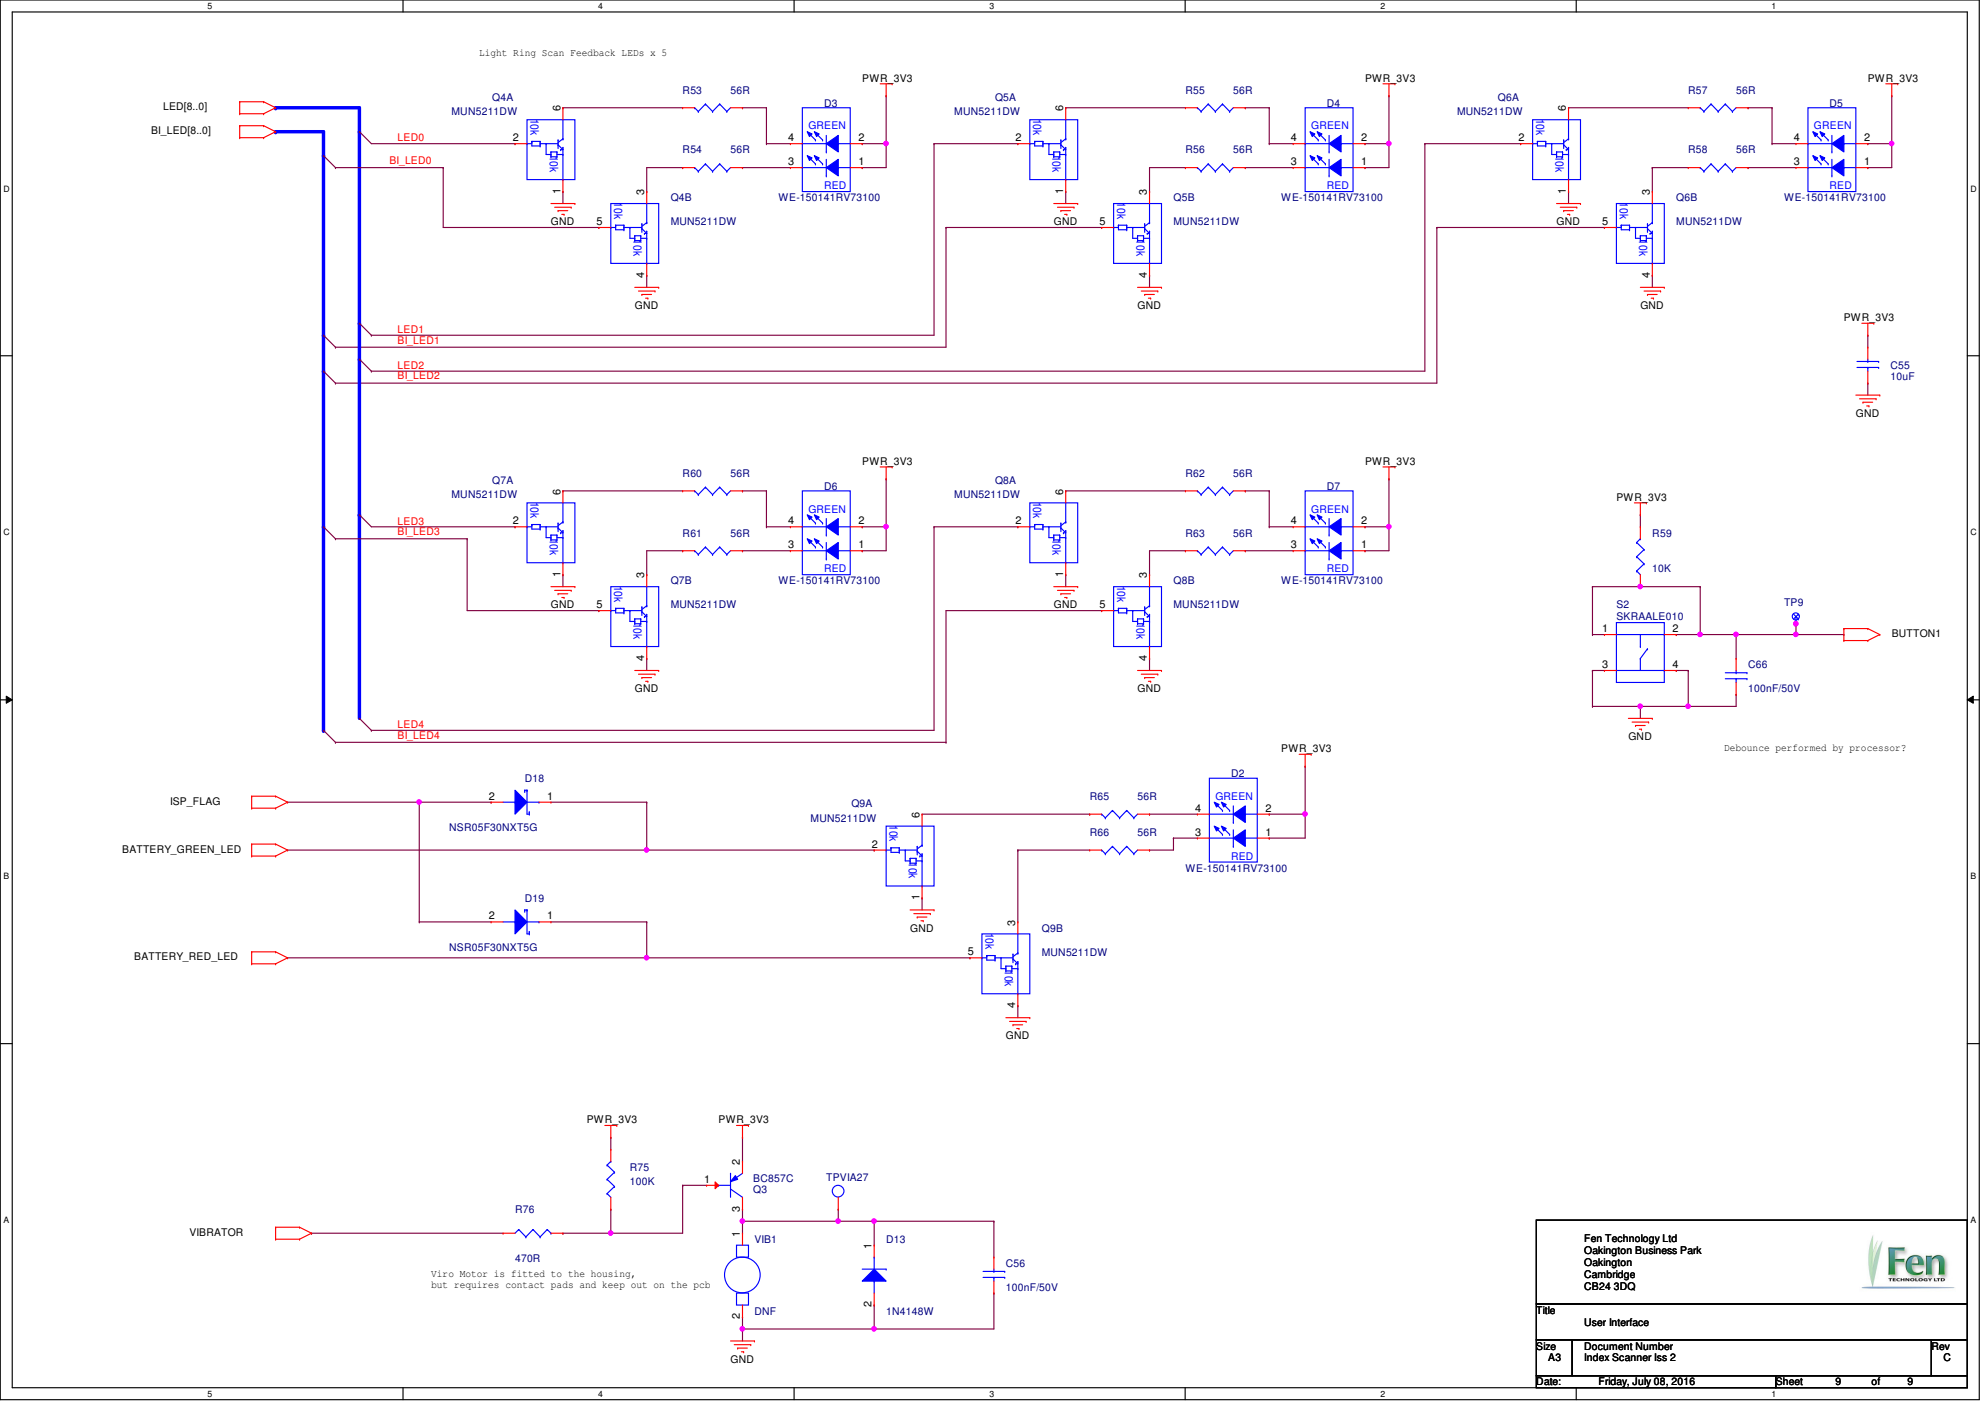
[picture p9: page 9]

Light Ring Scan Feedback LEDs x 5

Debounce performed by processor?

Viro Motor is fitted to the housing,
but requires contact pads and keep out on the pcb
