Samad-Simprints/Vero-Firmware/hw/scanner/schematic/schematic.pdf

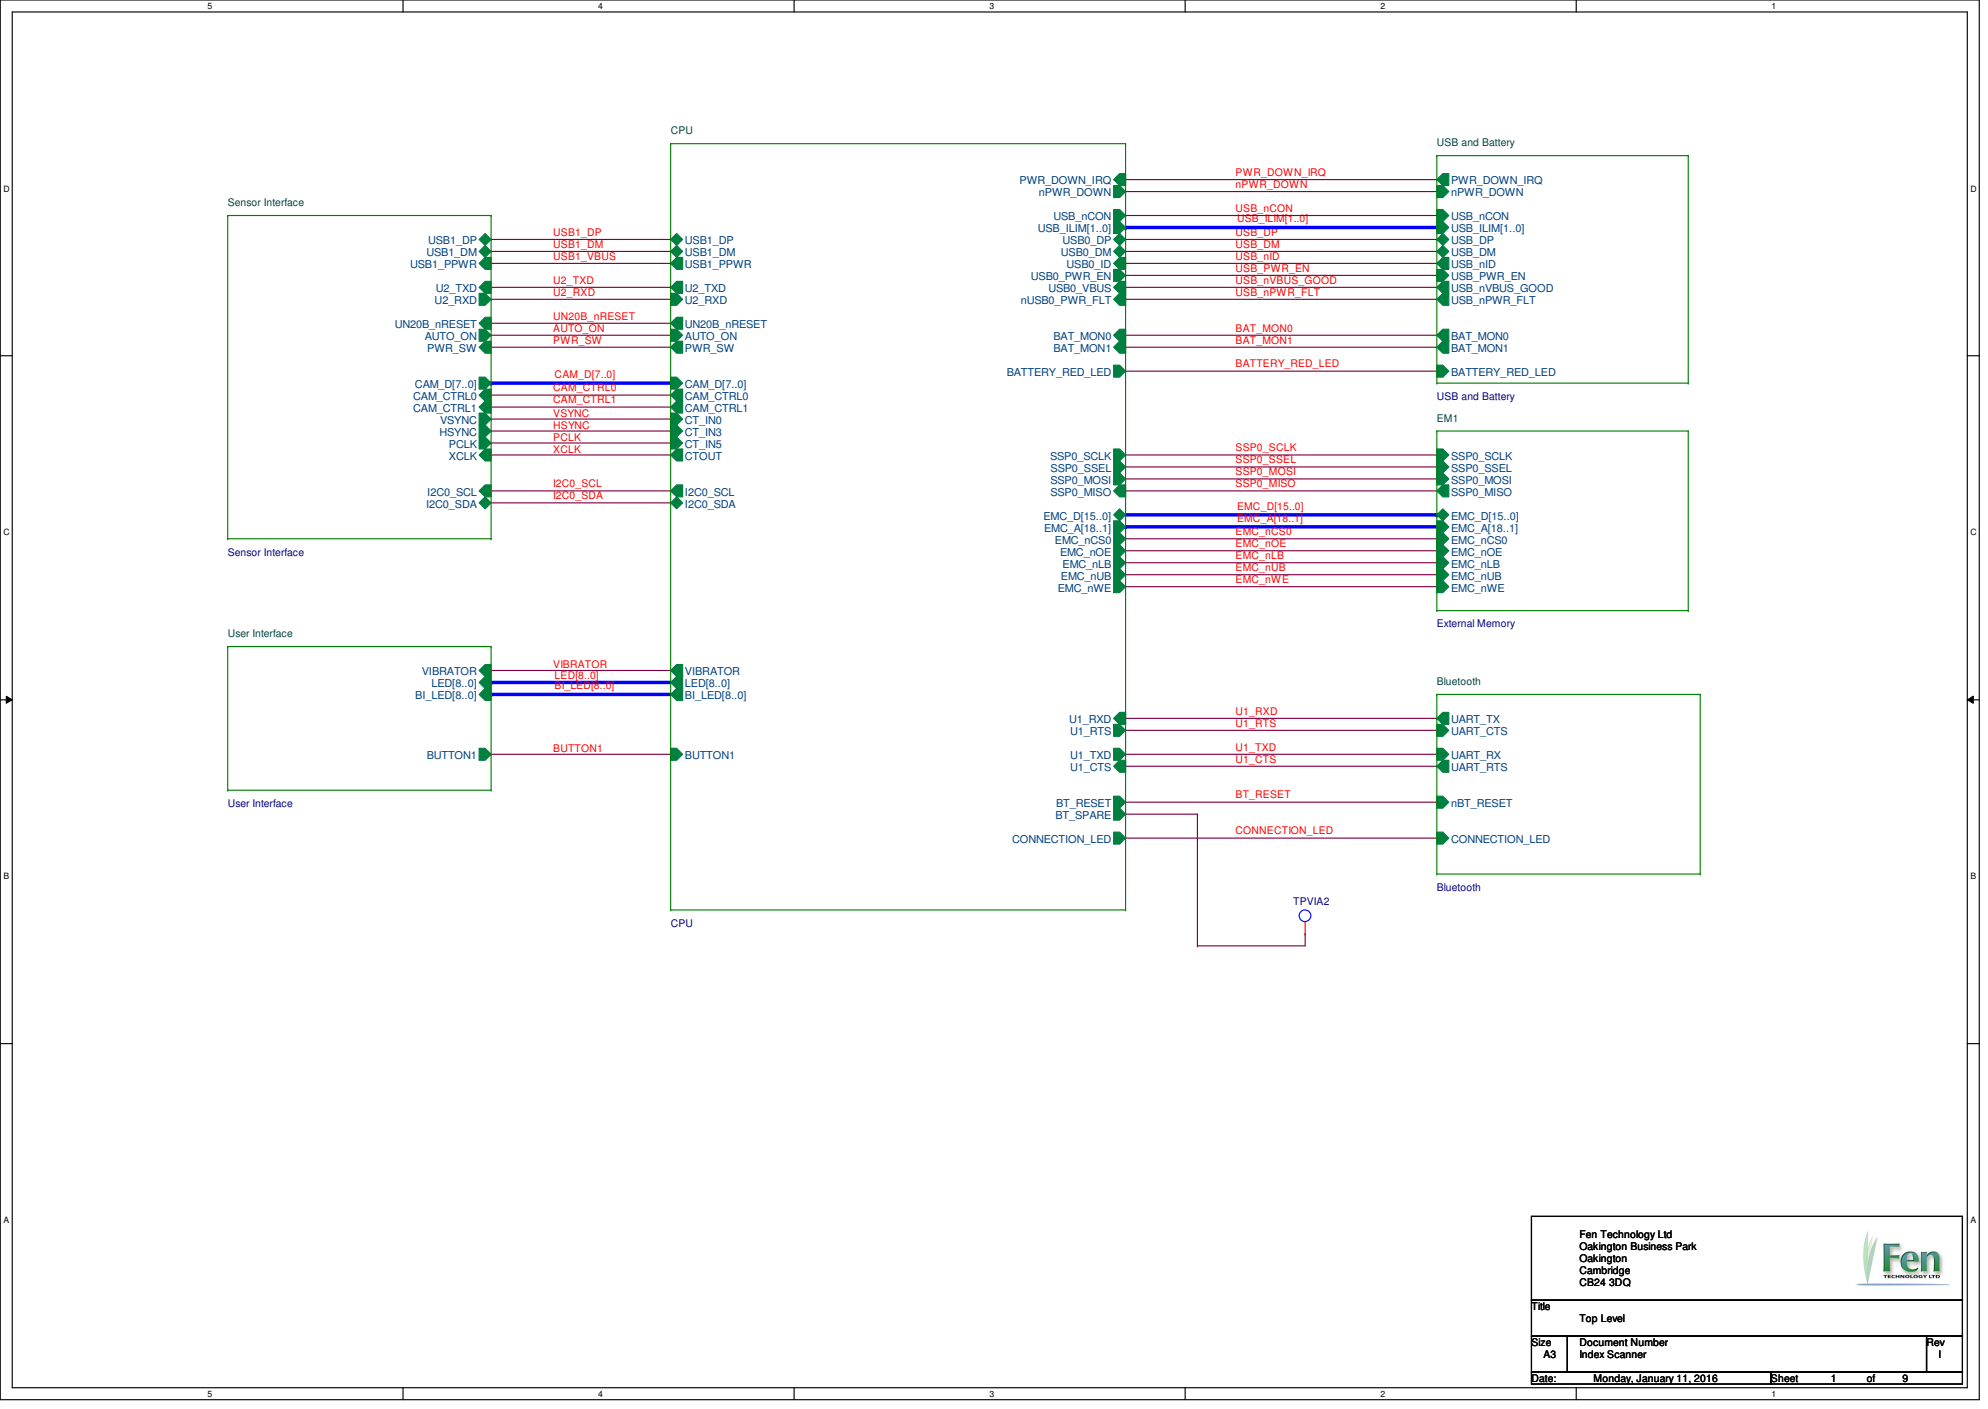
[picture p10: page 1]
SSP0_MISO; SSP0_MOSI; SSP0_SSEL; SSP0_SCLK; EMC_D[15..0] EMC_A[18..1] EMC_nCS0 EMC_nOE EMC_nLB EMC_nUB EMC_nWE; U1_RXD U1_RTS; U1_TXD U1_CTS; BT_RESET; USB_DP; USB_nVBUS_GOOD; USB1_DP; AUTO_ON; CAM_CTRL0 CAM_CTRL1 VSYNC HSYNC PCLK XCLK; I2C0_SCL I2C0_SDA; LED[8..0]; VIBRATOR; BUTTON1; USB_ILIM[1..0]; USB_nCON; BI_LED[8..0]; CONNECTION_LED; nPWR_DOWN; PWR_DOWN_IRQ; Title; Size; Document Number; Rev; Date:; Sheet; Index Scanner; Top Level; Monday, January 11, 2016; CPU; U2_RXD; EMC_nUB; U1_RTS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

USB and Battery

USB1_DM | USB_DM
USB1_VBUS | USB_nID
U2_TXD | USB_PWR_EN

U2_RXD | USB_nPWR_FLT

UN20B_nRESET | BAT_MON0

PWR_SW | BAT_MON1

CAM_D[7..0] | BATTERY_RED_LED

Fen Technology Ltd
Oakington Business Park
Oakington
Cambridge

## UART_TX

## UART_RX

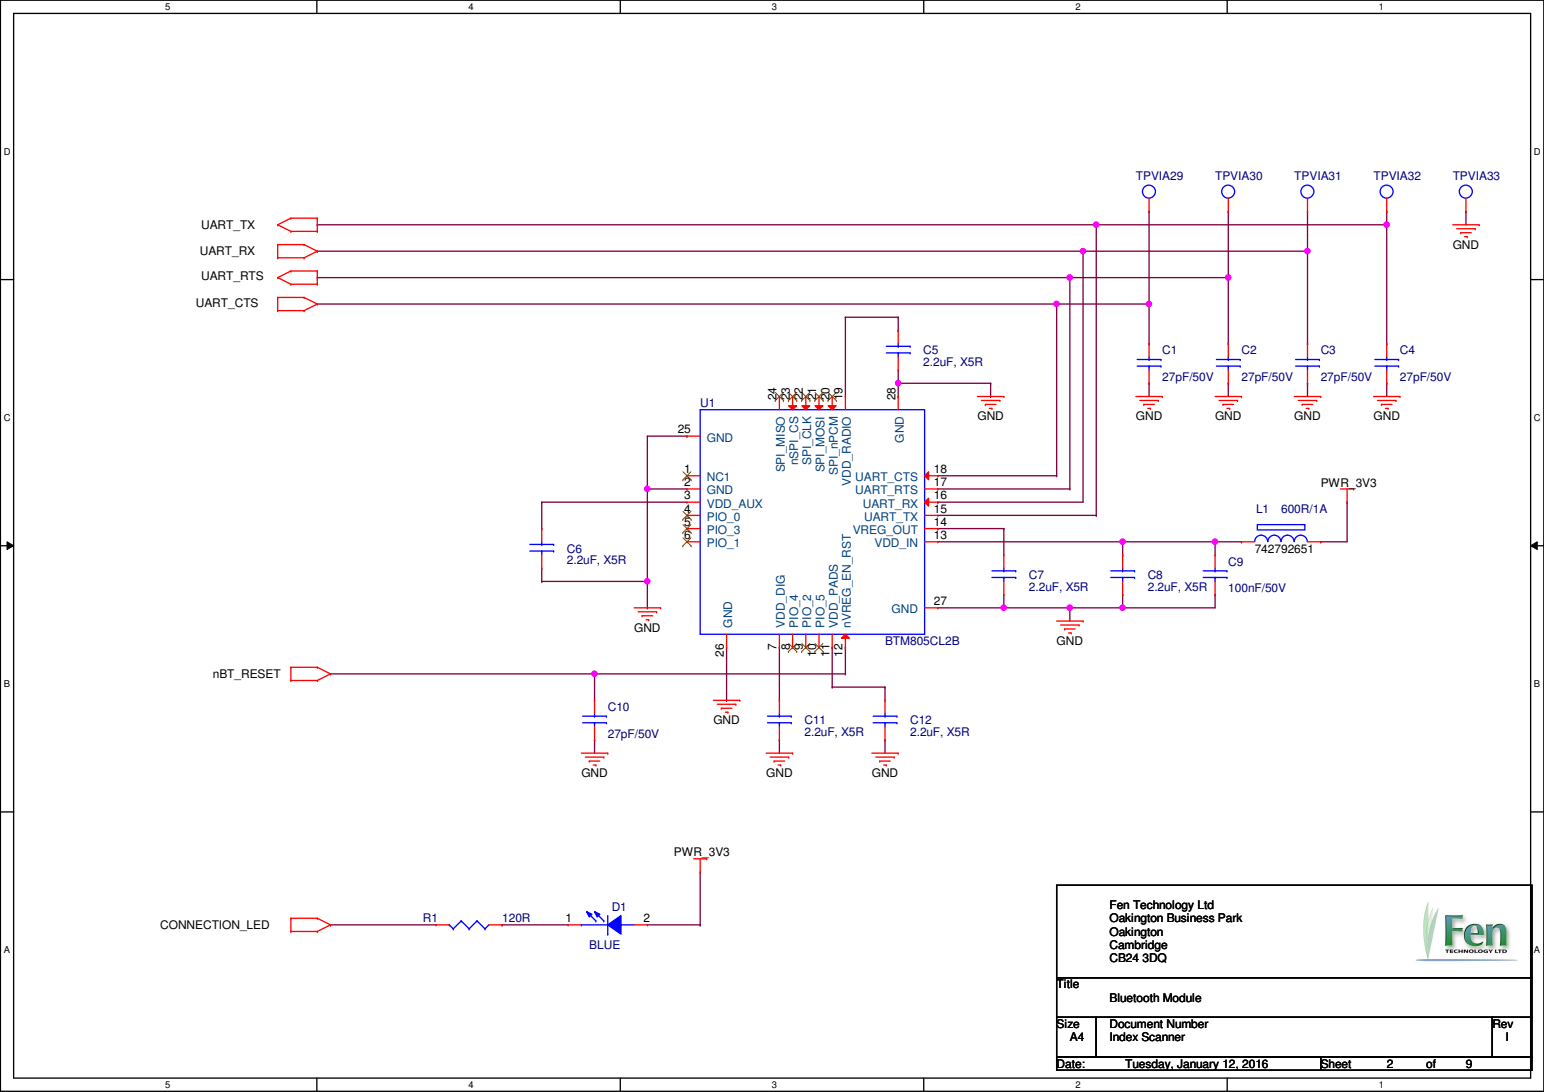
[picture p11: page 2]

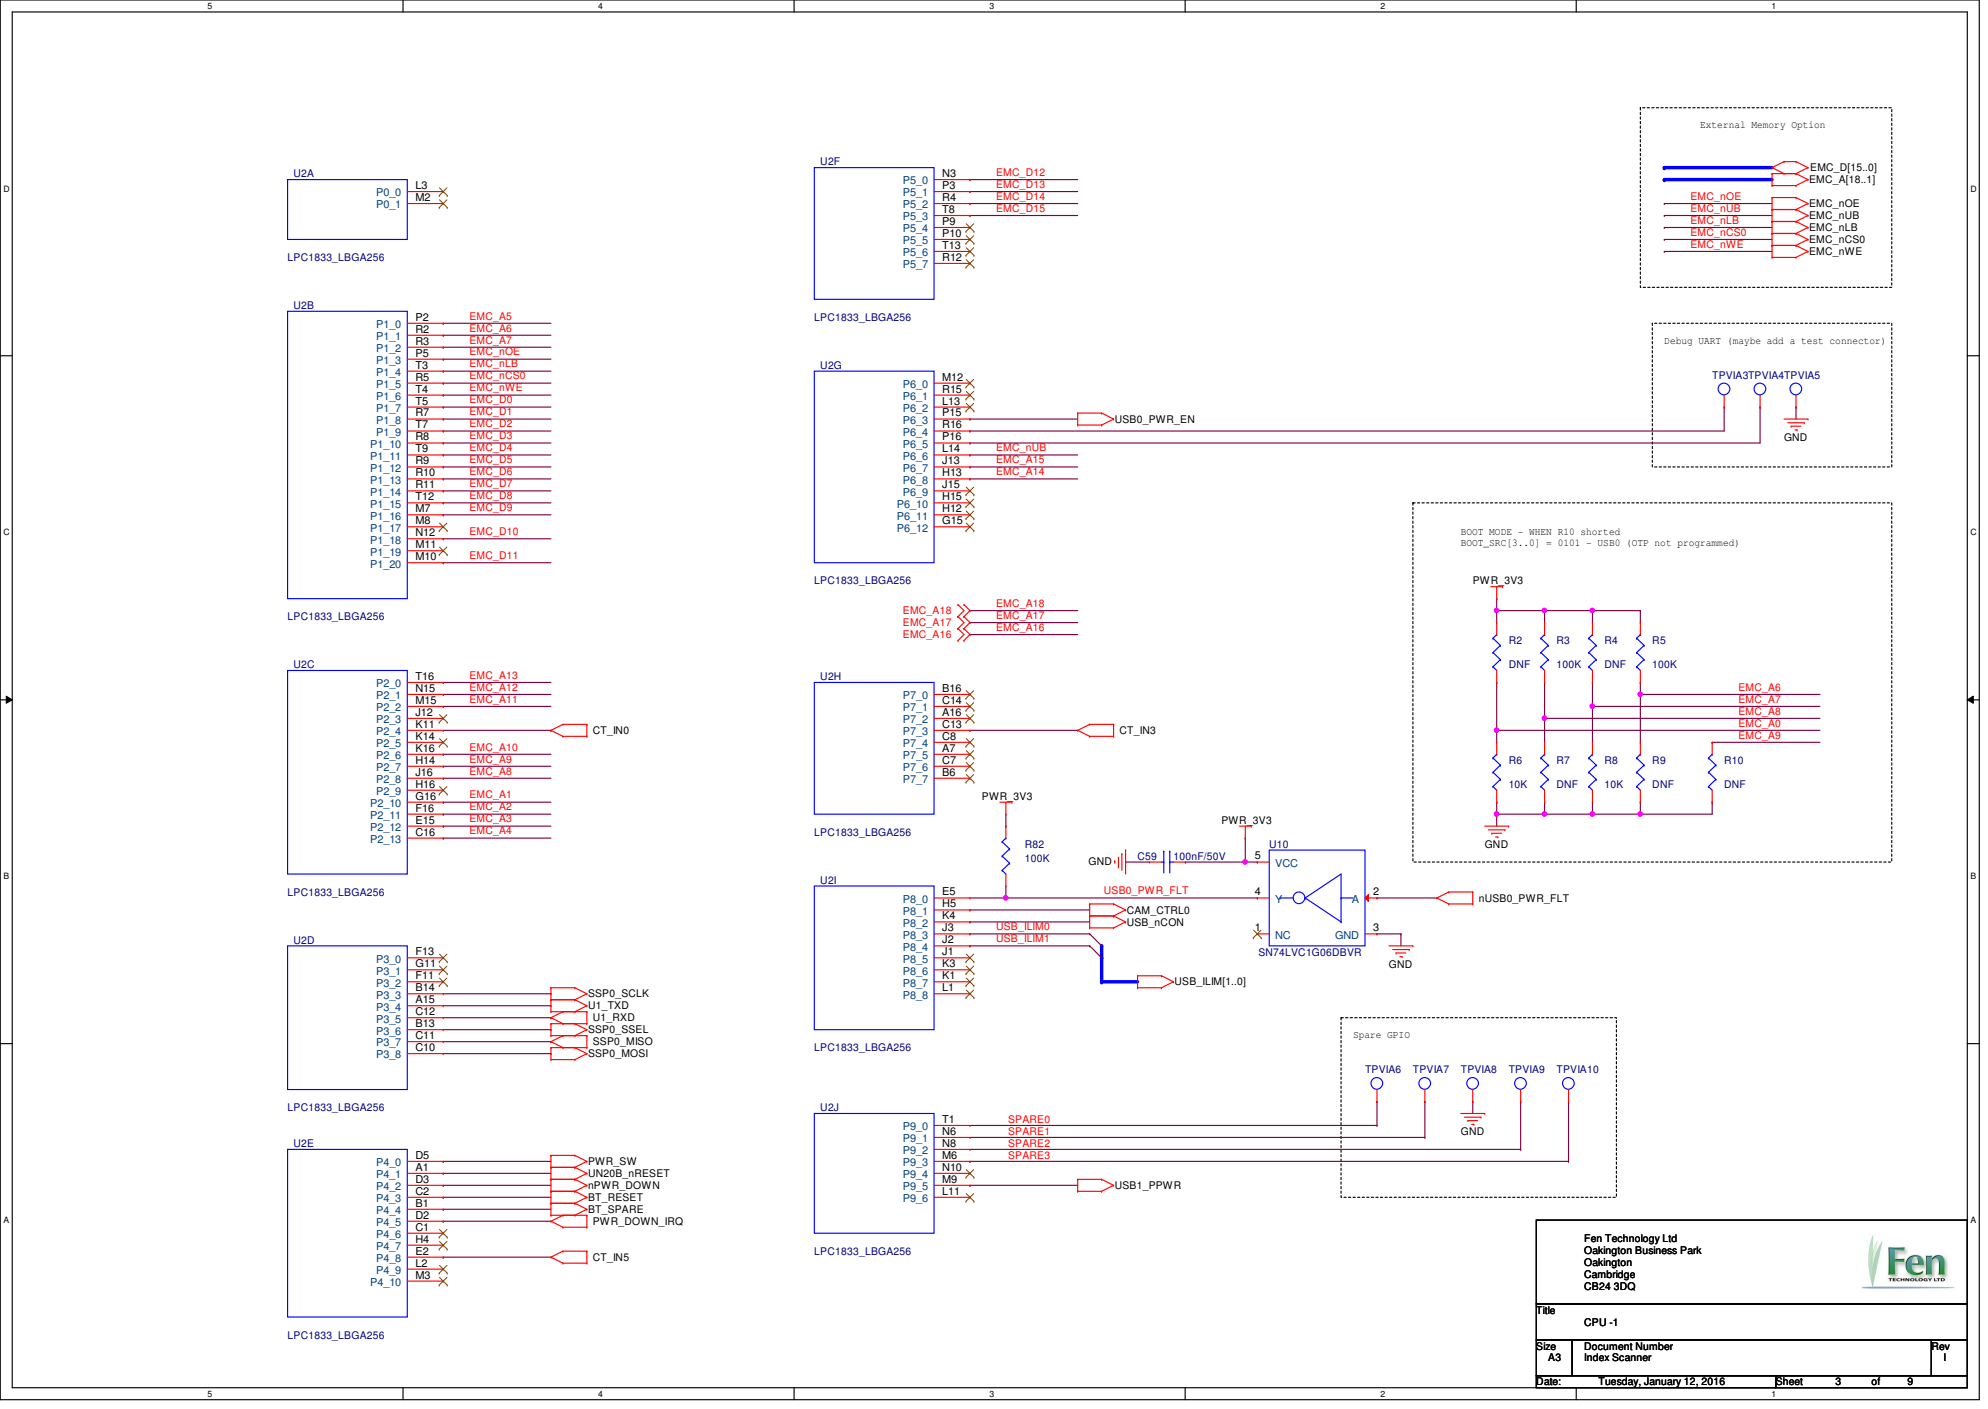
[picture p12: page 3]

Debug UART (maybe add a test connector)

BOOT MODE - WHEN R10 shorted
BOOT_SRC[3..0] = 0101 - USB0 (OTP not programmed)

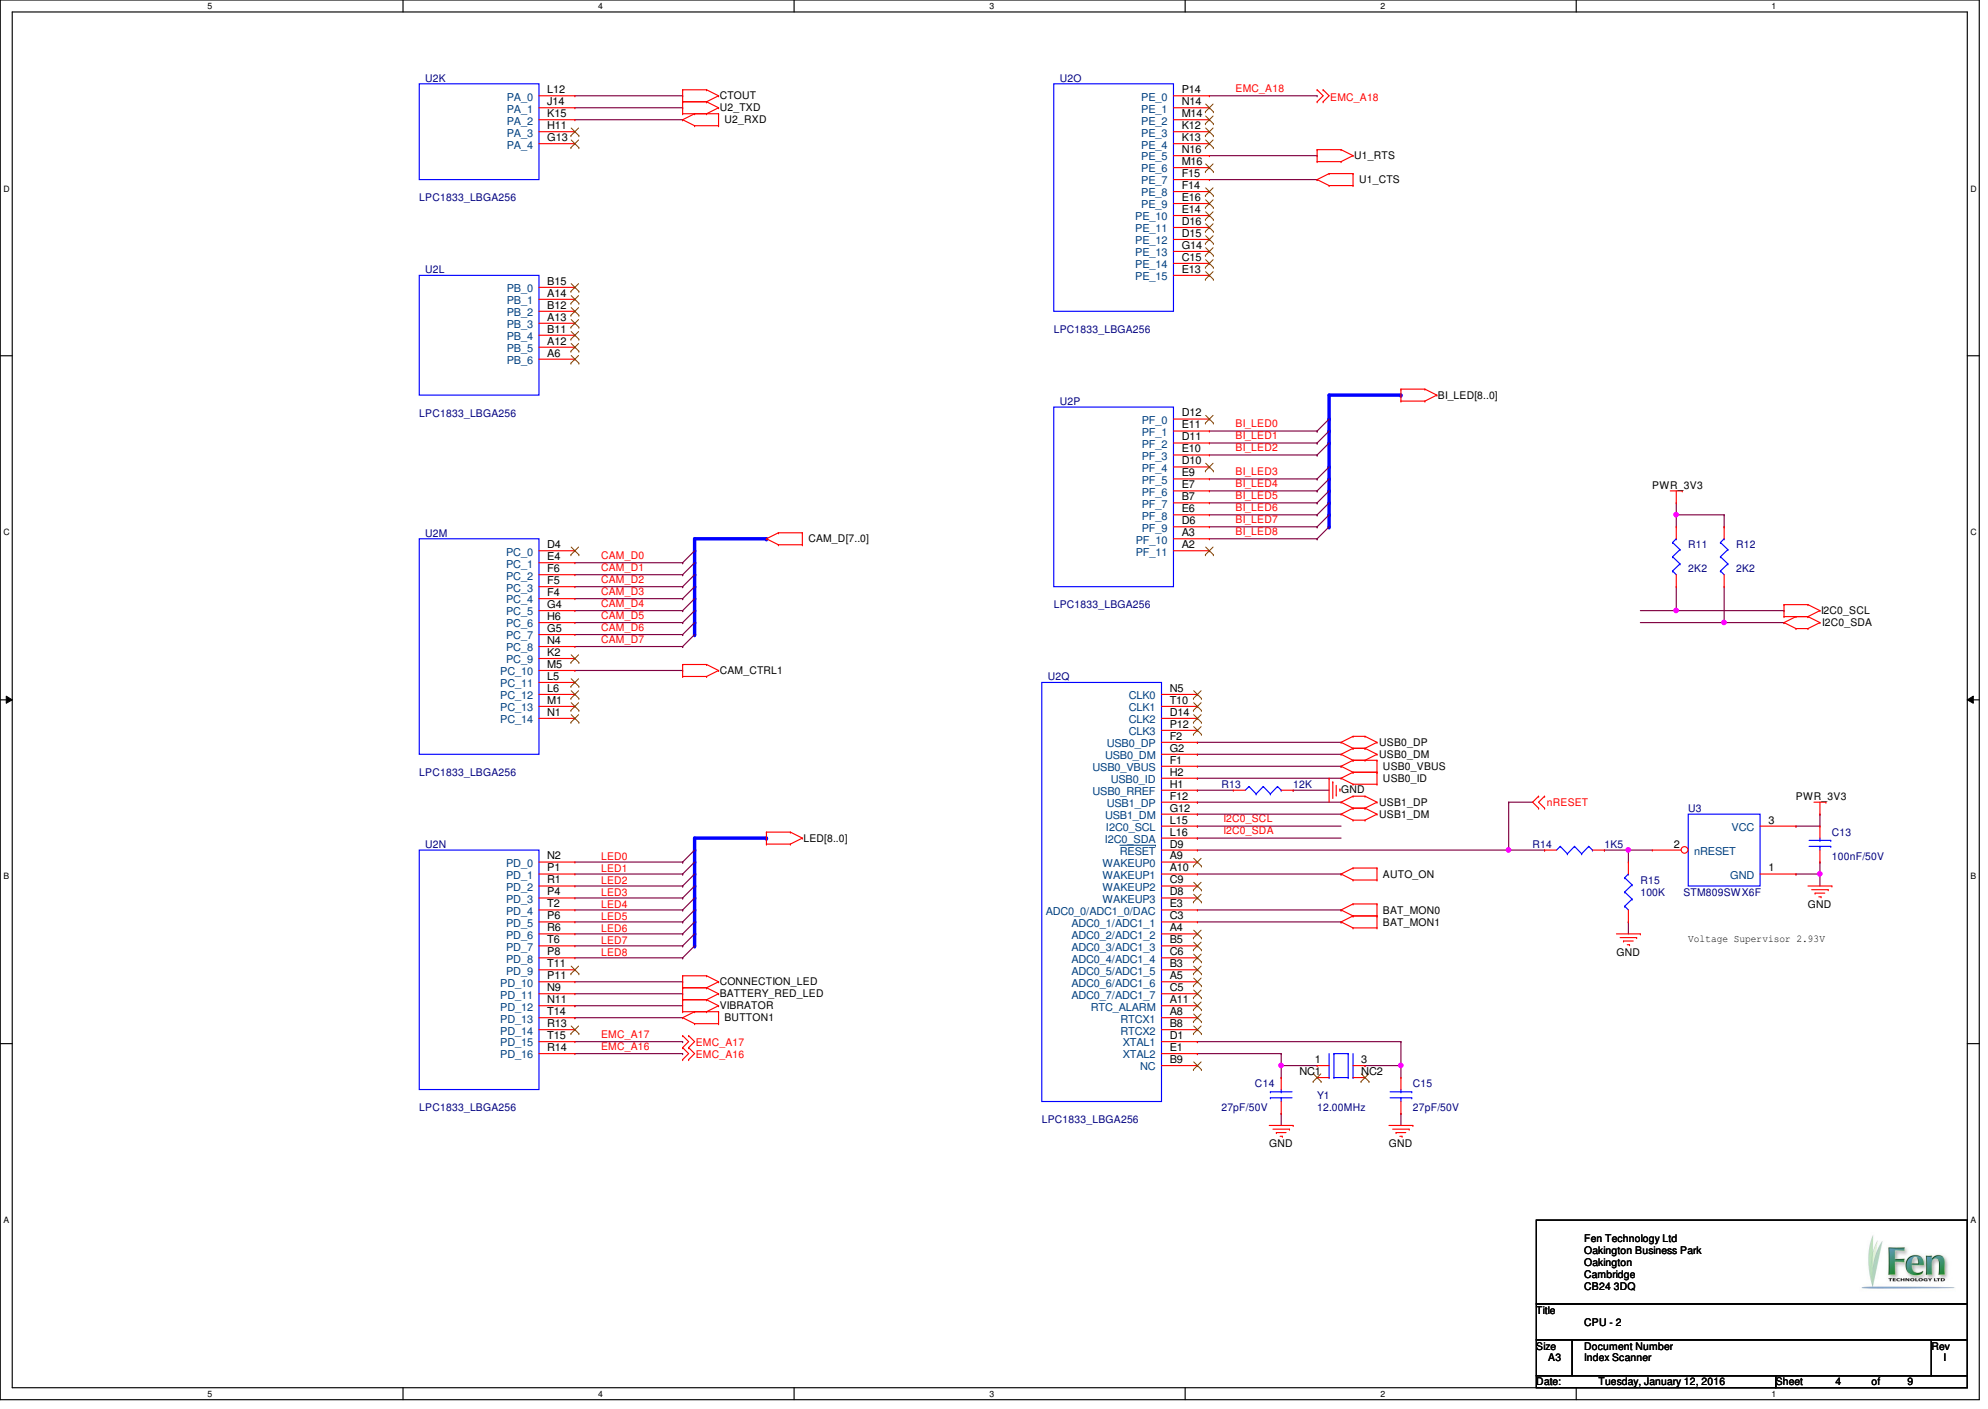
[picture p13: page 4]

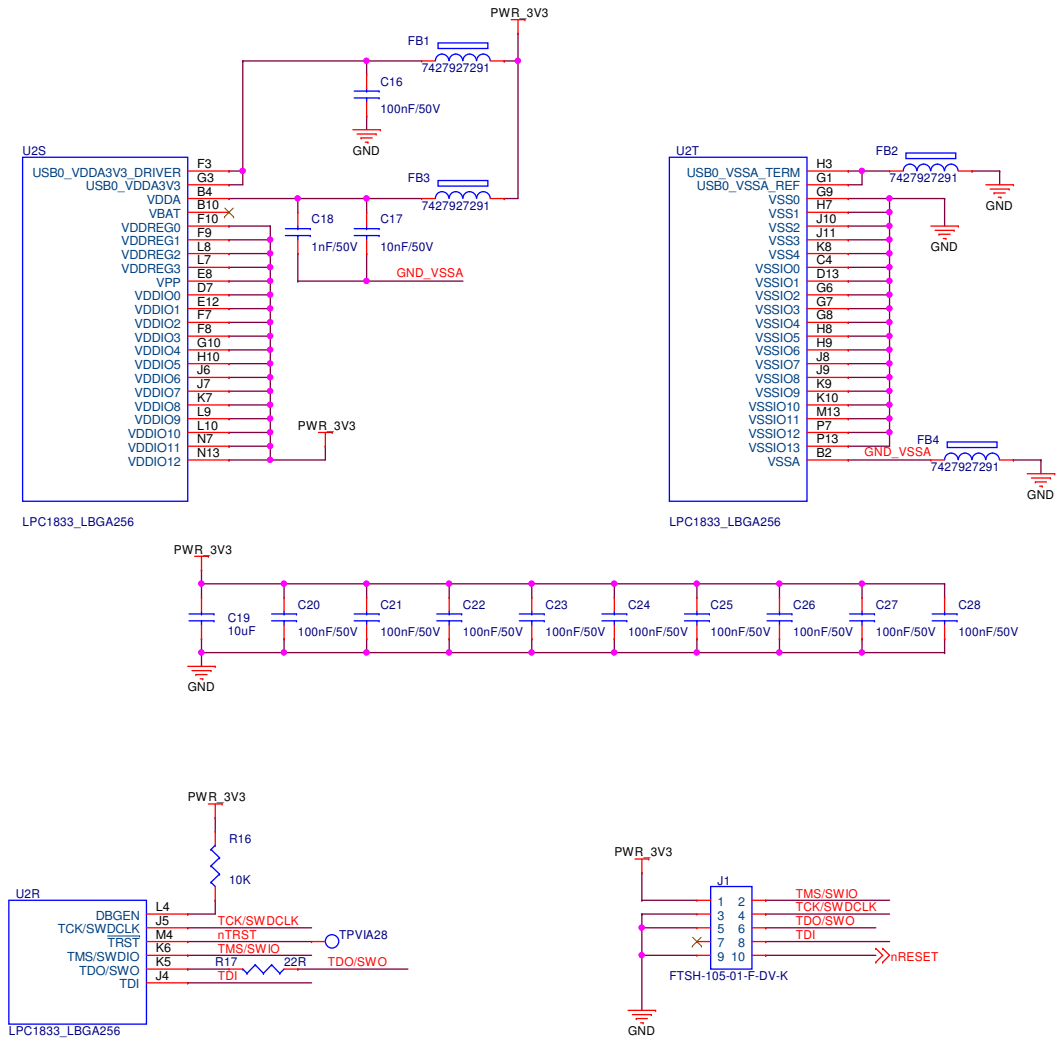
[picture p14: page 5]

D | D

## SSP0_SCLK

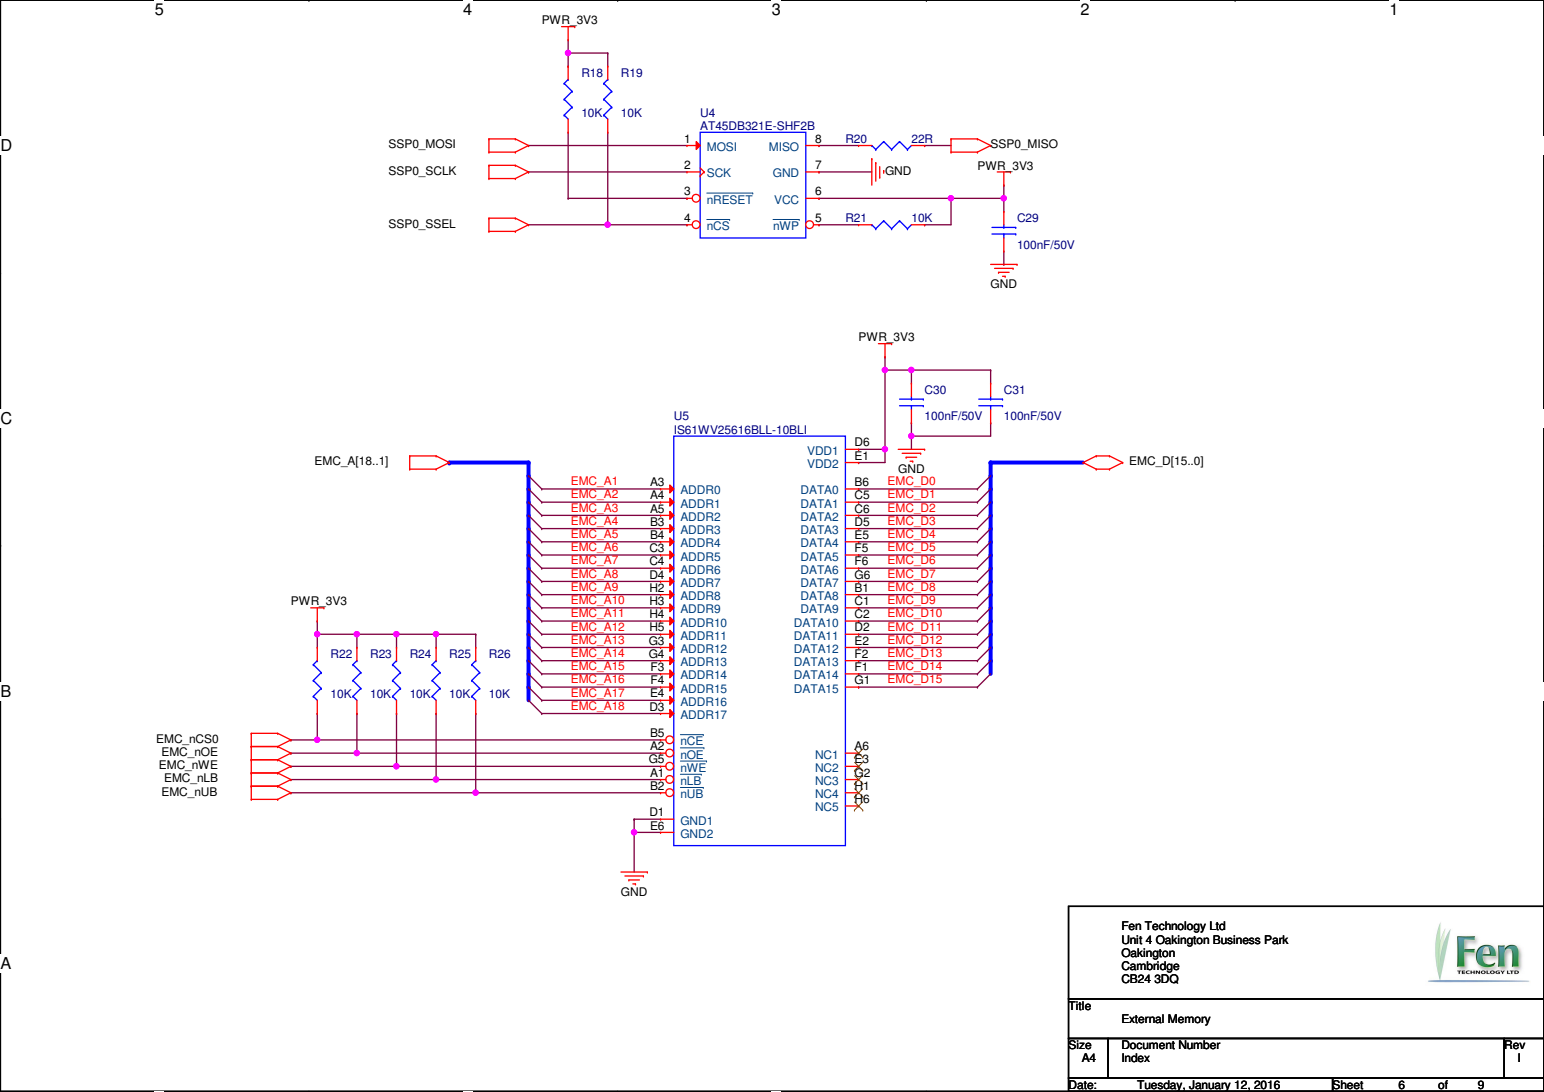
[picture p15: page 6]

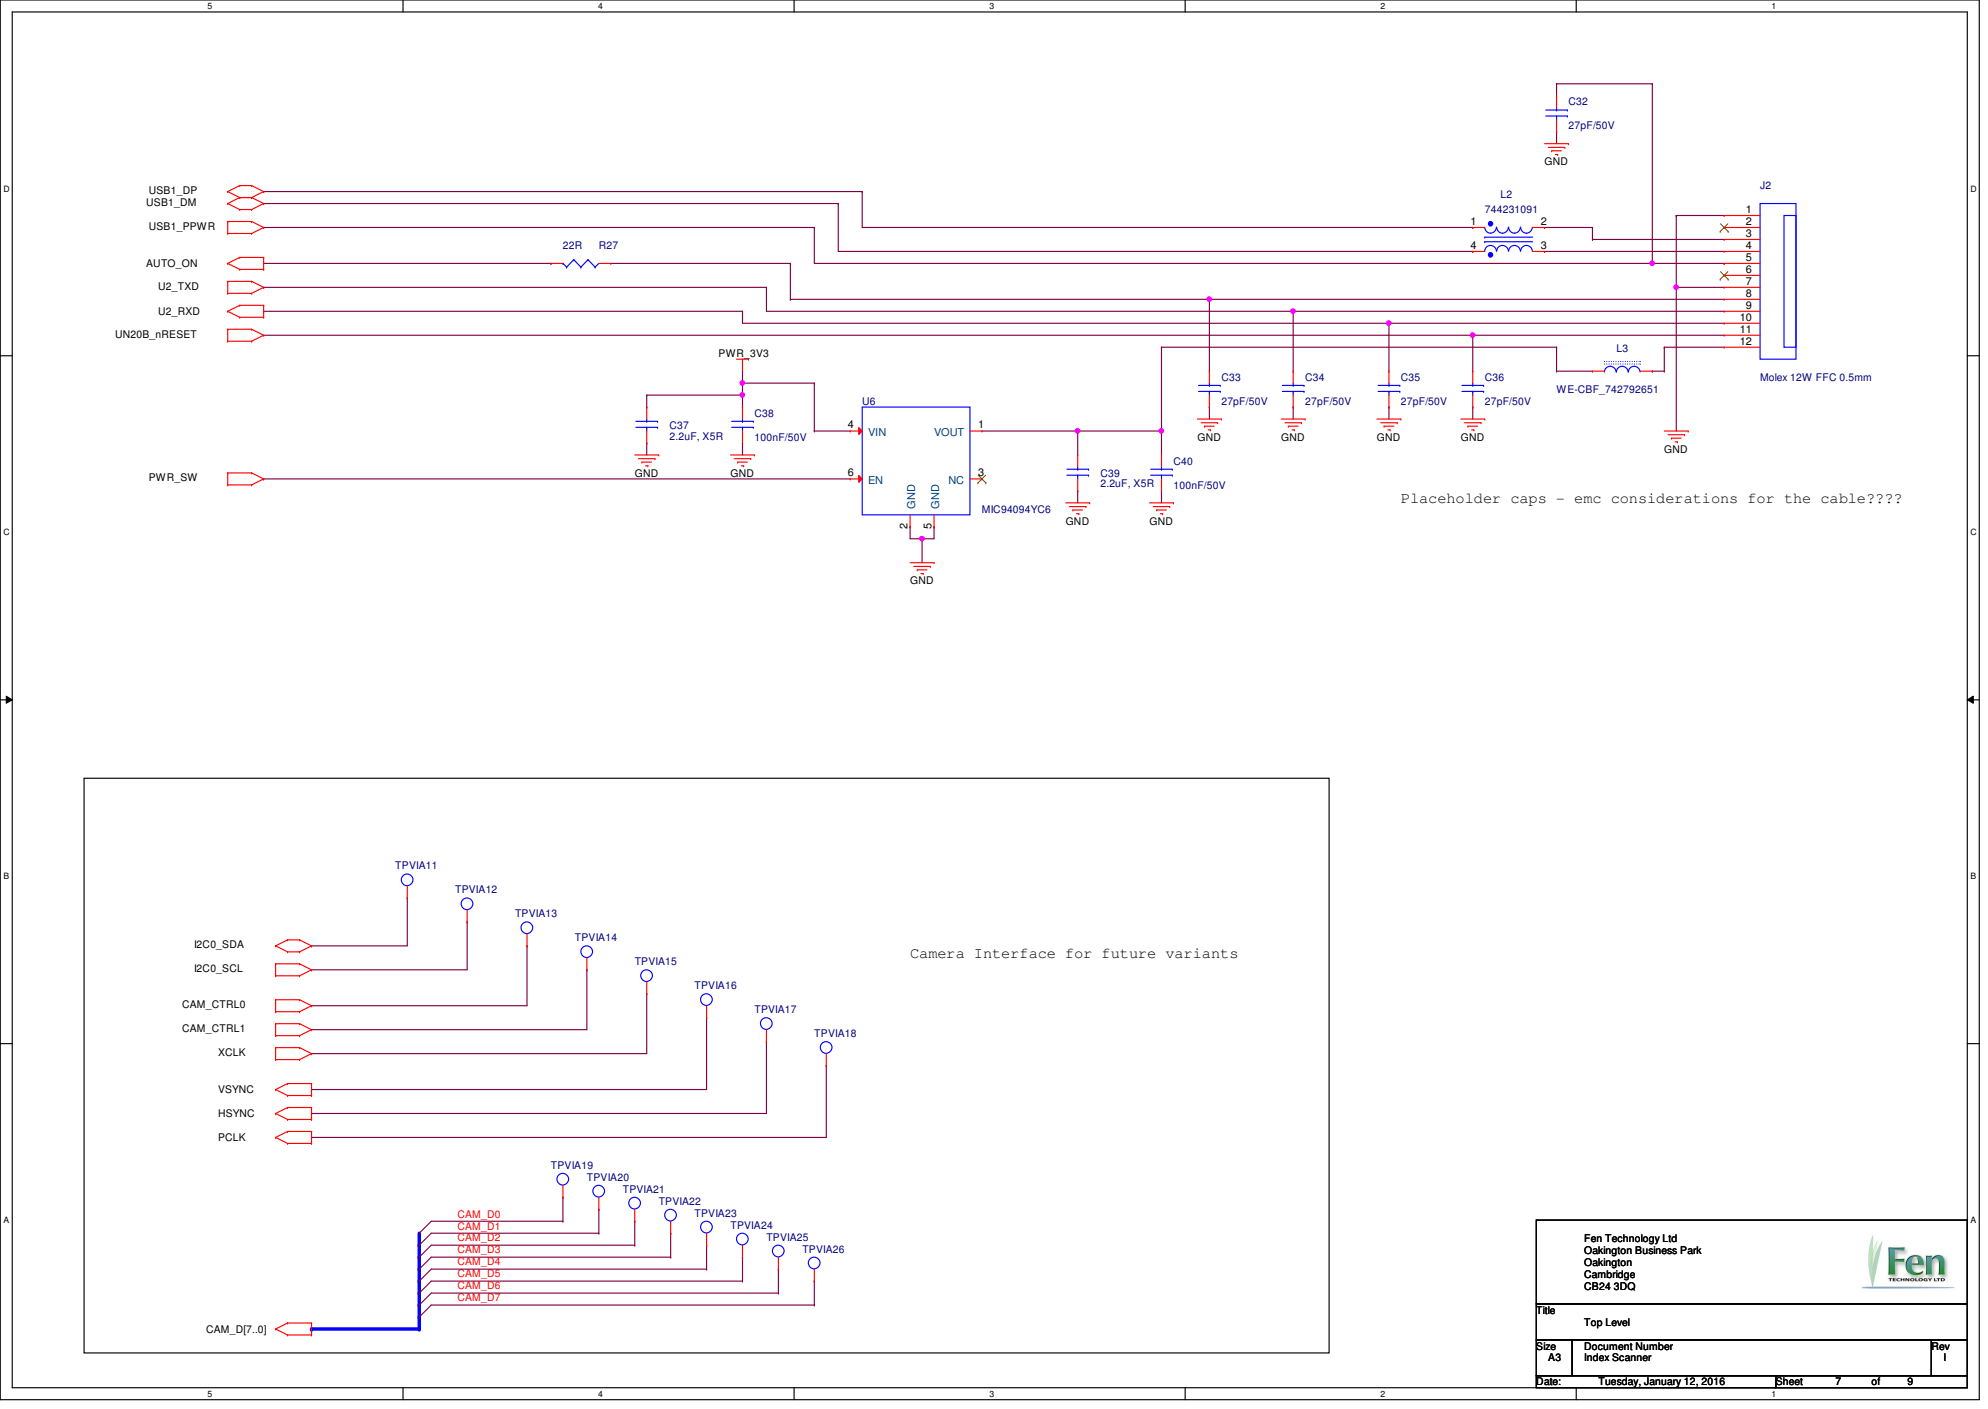
[picture p16: page 7]

Placeholder caps - emc considerations for the cable????

Camera Interface for future variants

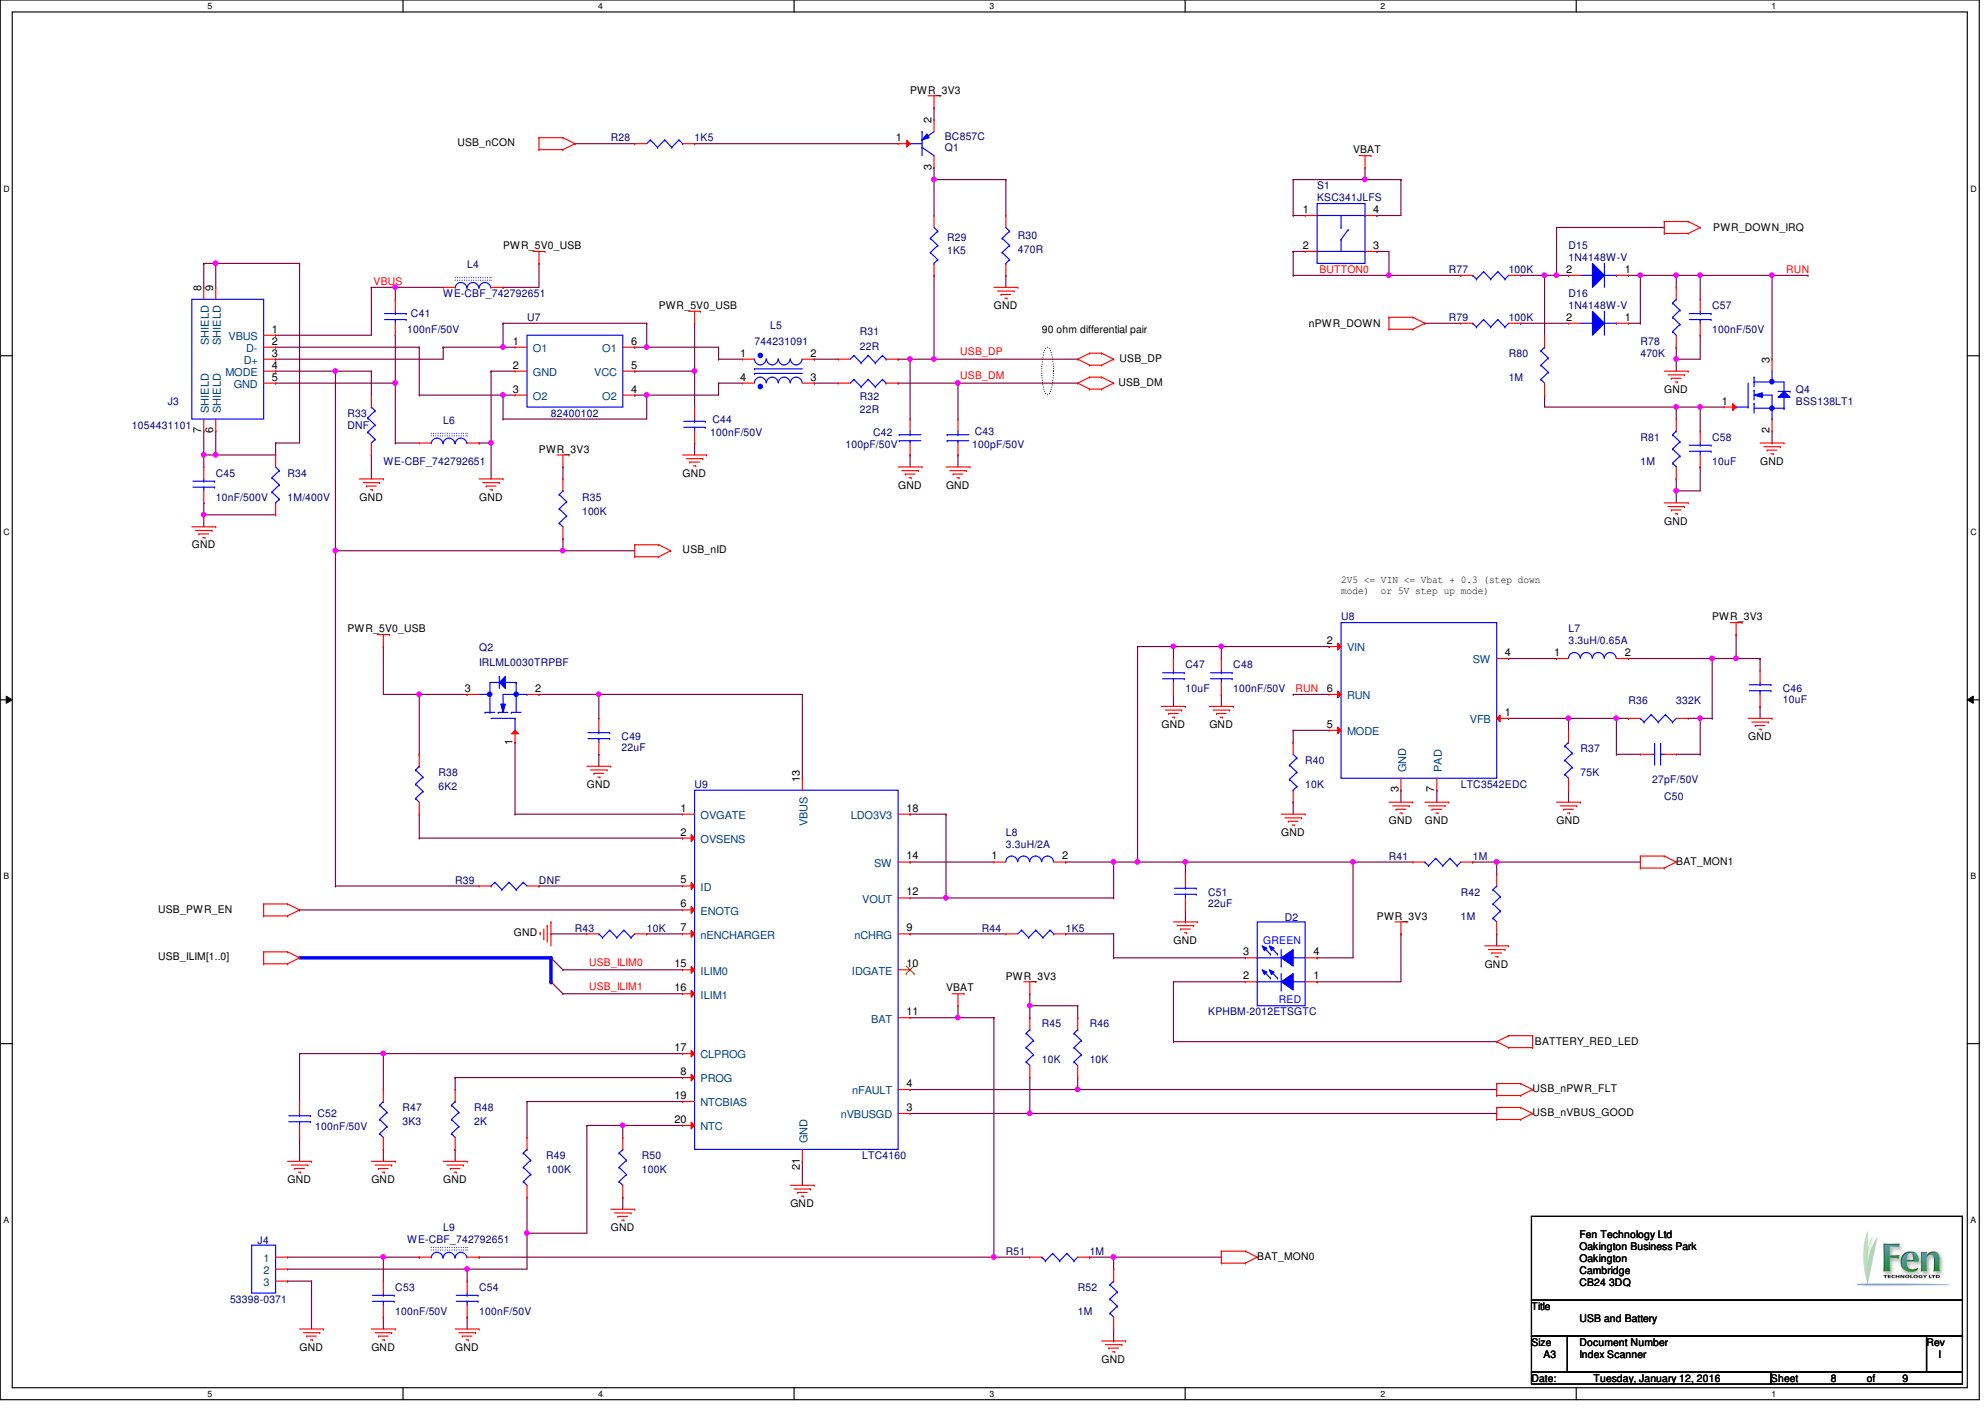
[picture p17: page 8]

2V5 <= VIN <= Vbat + 0.3 (step down

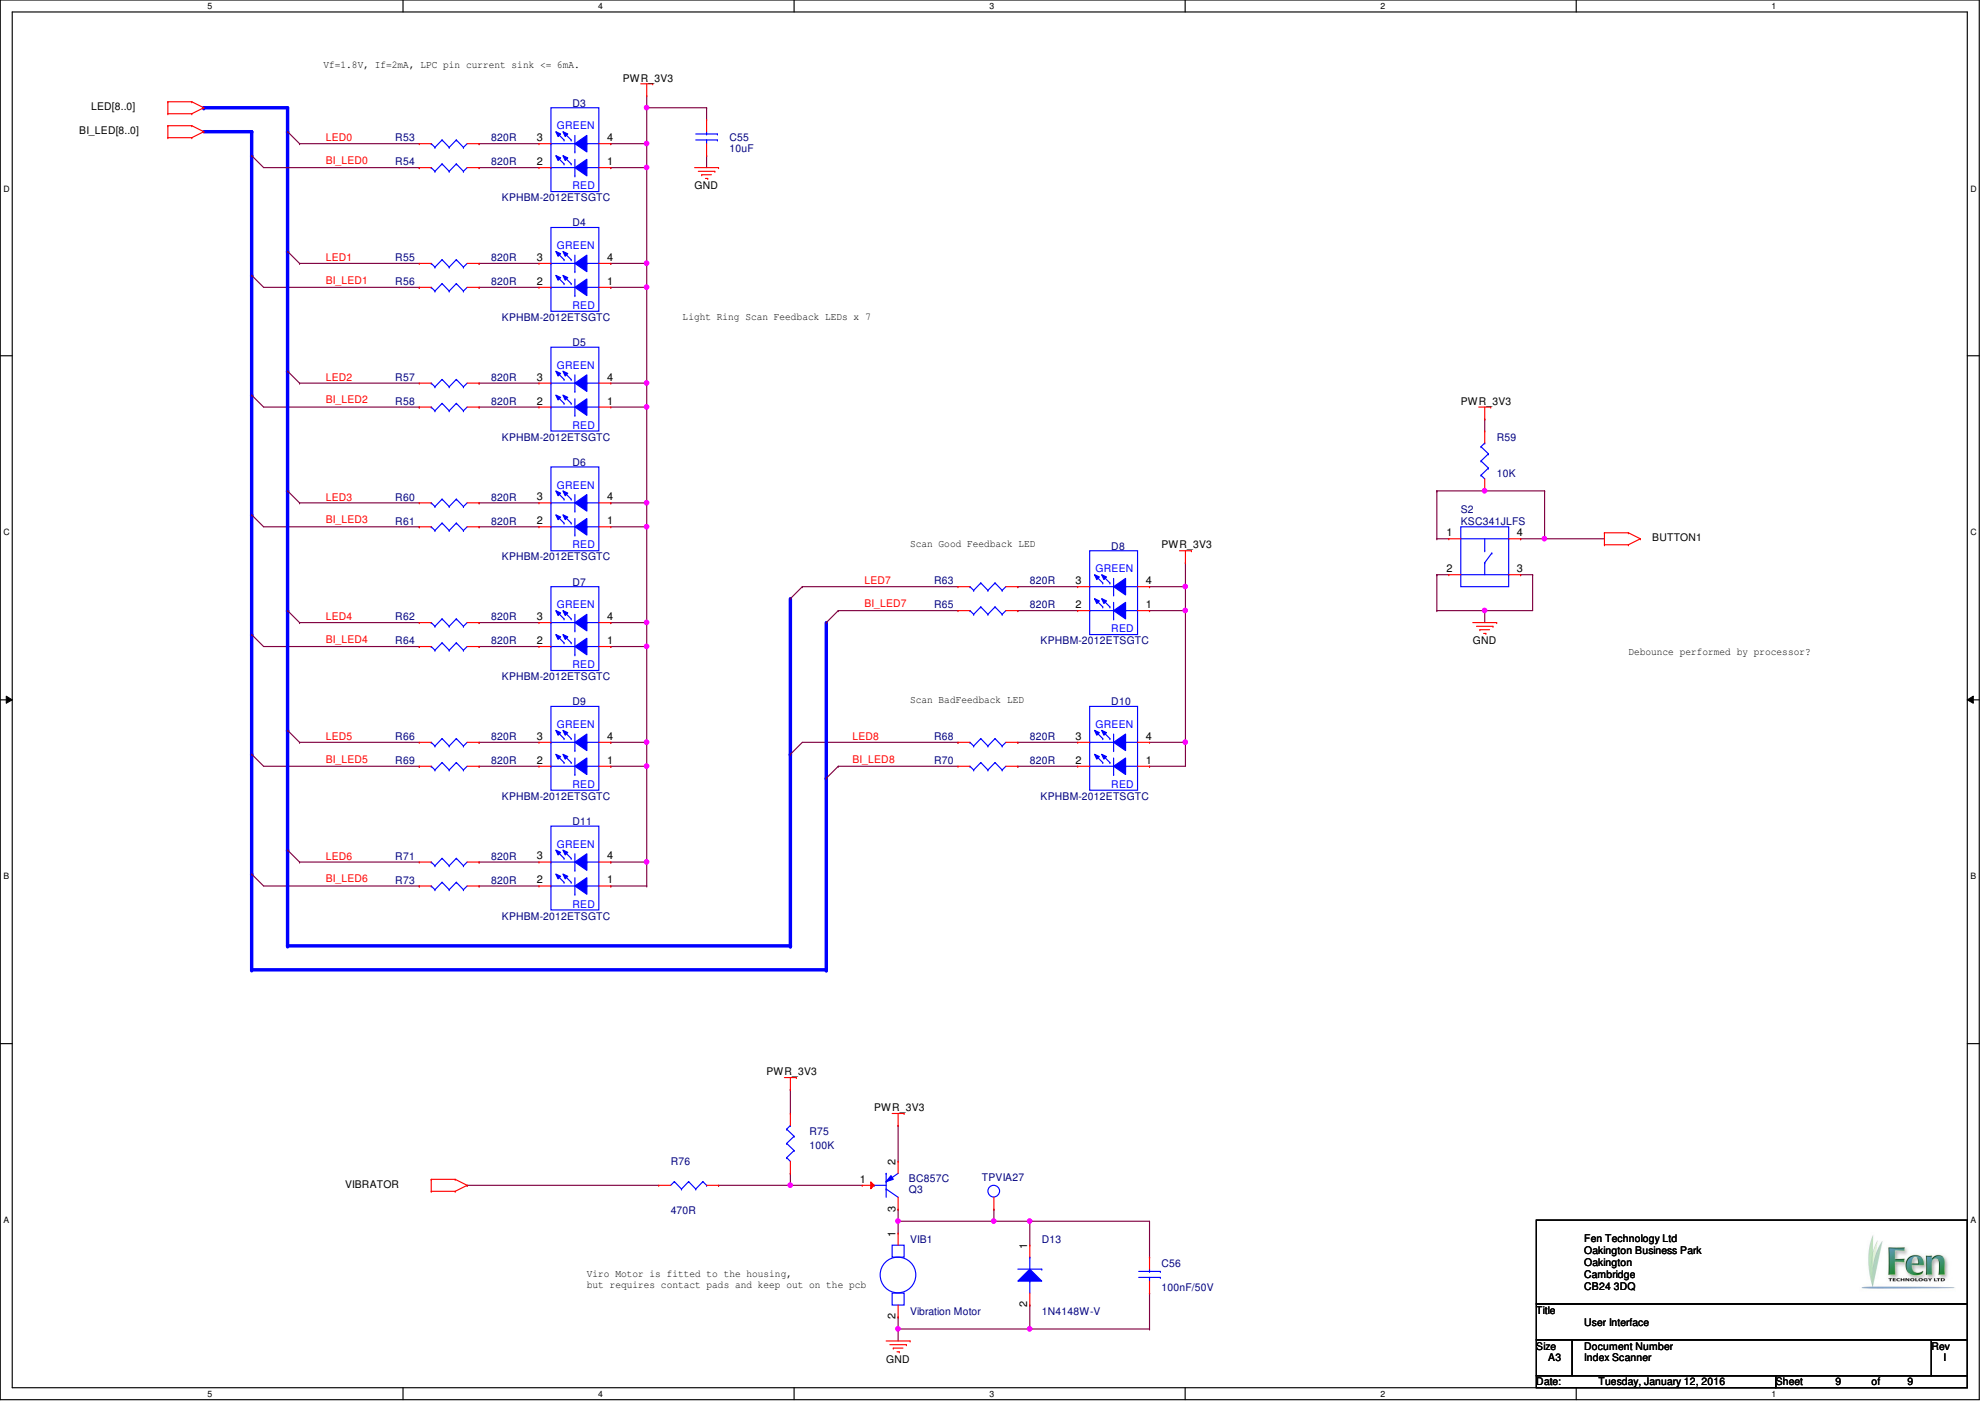
[picture p18: page 9]

Vf=1.8V, If=2mA, LPC pin current sink <= 6mA.

Light Ring Scan Feedback LEDs x 7

Scan Good Feedback LED

Debounce performed by processor?

Viro Motor is fitted to the housing,
but requires contact pads and keep out on the pcb
