Samad-Simprints/Vero-Firmware/hw/scanner/pcb/Scanner-Index_Btm_Assy.pdf

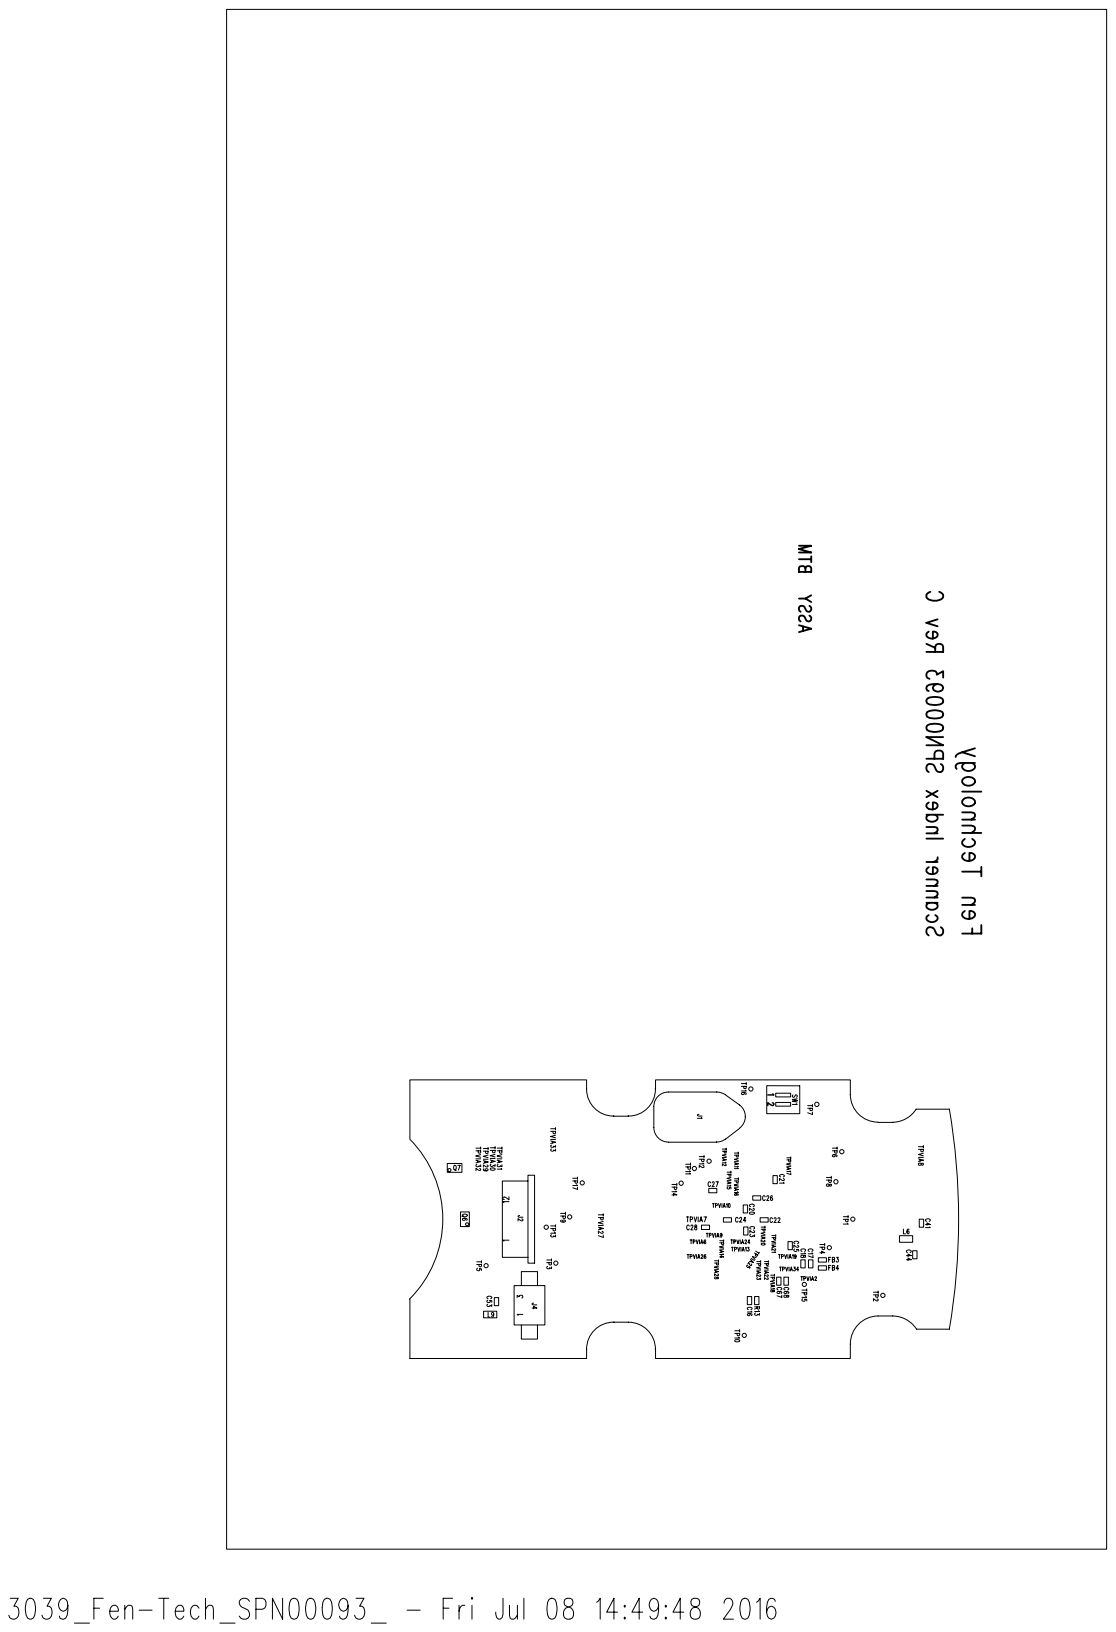
[picture p19: page 1]
