Samad-Simprints/Vero-Firmware/hw/scanner/pcb/Scanner-Index_Top_Assy.pdf

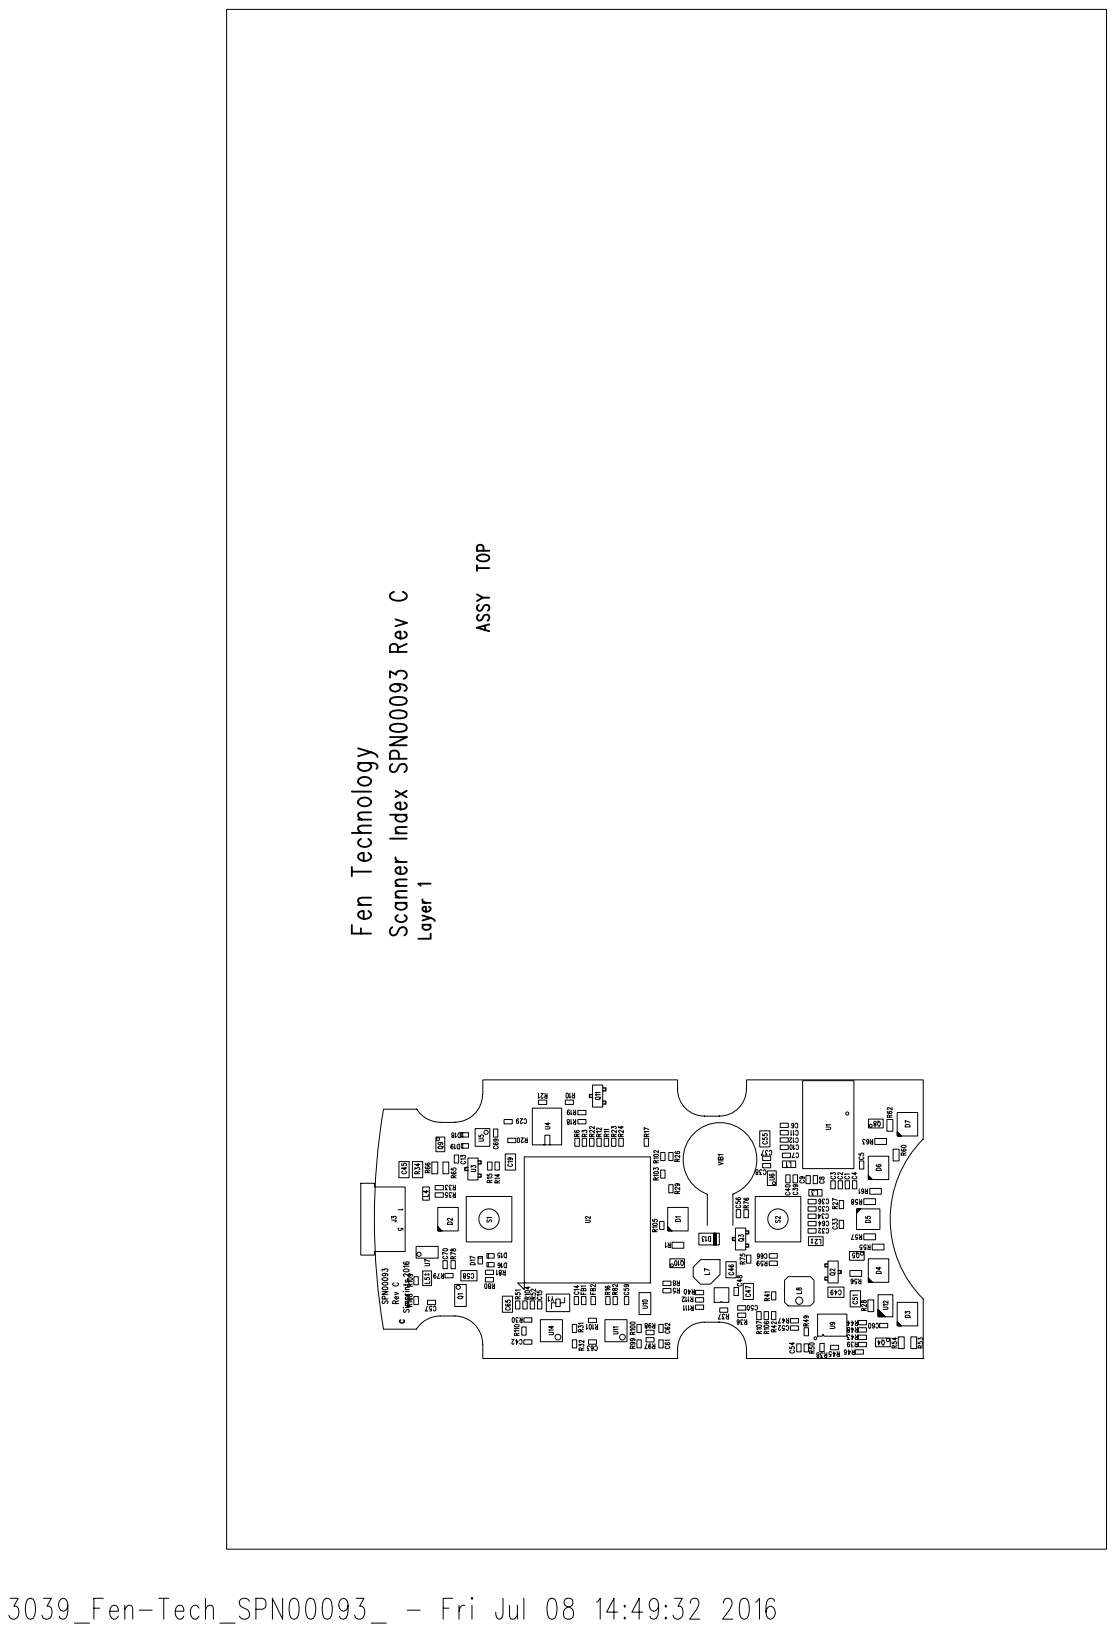
[picture p20: page 1]
