Samad-Simprints/Vero-Firmware/(list of files, drawings)

Other design files:
hw/scanner/pcb/layout.pcb
hw/scanner/schematic/LPC18XX_43XX.OLB
hw/scanner/schematic/lpc18xx_43xx.opj
hw/scanner/schematic/LPC18XX_43XX_SCH.DSN
hw/scanner/schematic/SCANNER.DSN
hw/scanner/schematic/SCANNER.OLB
hw/scanner/schematic/scanner.opj
hw/scanner/schematic/SCANNER_REVB.DSN
hw/scanner/schematic/scanner_revb.opj
hw/scanner/schematic/SCANNER_REVC.DSN
hw/scanner/schematic/scanner_revc.opj
hw/scanner/schematic/UN20B_INTERFACE.DSN
hw/scanner/schematic/UN20B_INTERFACE.OLB
hw/scanner/schematic/UN20B_interface.opj
hw/scanner/schematic/UN20EX1_INTERFACE.DSN
hw/scanner/schematic/un20ex1_interface.opj
scanner/schematic/SCANNER.DSN
scanner/schematic/SCANNER.OLB
scanner/schematic/scanner.opj
