Samad-Simprints/Vero-Firmware/fw/dotstack/dotstack/cortex-m3-gcc/include/cdbt/hfp/hfp.h

/*******************************************************************************
* Contains proprietary and confidential information of SEARAN LLC.
* May not be used or disclosed to any other party except in accordance
* with a license from SEARAN LLC.
* Copyright (c) 2011-2015 SEARAN LLC. All Rights Reserved.
*
* SEARAN LLC is the exclusive licensee and developer of dotstack with
* all its modifications and enhancements.
*
* Contains proprietary and confidential information of CandleDragon and
* may not be used or disclosed to any other party except in accordance
* with a license from SEARAN LLC.
* Copyright (c) 2009, 2010, 2011 CandleDragon. All Rights Reserved.
*******************************************************************************/

#ifndef __HFP_H
#define __HFP_H

/**
* \defgroup hfp Hands Free Profile (HFP)
*/

#include "cdbt/sdp/sdp.h"
#include "cdbt/utils/at_parser.h"

#ifdef __cplusplus
extern "C" {
#endif

#define HFP_ROLE_HF			0
#define HFP_ROLE_AG			1


#define HFP_SESSION_PHASE_IDLE						0
#define HFP_SESSION_PHASE_WAITING_RFCOMM_CONNECT	1
#define HFP_SESSION_PHASE_WAITING_SCO_CONNECT		2
#define HFP_SESSION_PHASE_CONNECTING				3
#define HFP_SESSION_PHASE_WAITING_CMD_RESPONSE		4

#define HFP_SESSION_STATE_FREE						0xffff
#define HFP_SESSION_STATE_DISCONNECTED				0x0000
#define HFP_SESSION_STATE_SLC_CONNECTED				0x0001
#define HFP_SESSION_STATE_SCO_CONNECTED				0x0002
#define HFP_SESSION_STATE_CONNECTED					0x0003
#define HFP_SESSION_STATE_SLC_SETUP					0x0004
#define HFP_SESSION_STATE_CONNECTING				0x0008
#define HFP_SESSION_STATE_CALL_REFRESH_IN_PROGRESS	0x0010
#define HFP_SESSION_STATE_CALL_REFRESH_PENDING		0x0020
#define HFP_SESSION_STATE_ENABLING_VR				0x0040
#define HFP_SESSION_STATE_SCO_DISCONNECTING			0x0080
#define HFP_SESSION_STATE_SCO_CONNECTING			0x0100
#define HFP_SESSION_STATE_SEARCHING_HEADSETS        0x0200
#define HFP_SESSION_STATE_SENDING_AUDIO_PACKET      0x0400
#define HFP_SESSION_STATE_SENDING_CALL_LIST         0x0800

#define HFP_CODEC_TYPE_PCM                          1
#define HFP_CODEC_TYPE_MSBC                         2

#define HFP_EVENT_NOTHING                             0
/**
* This event is reported when SLC connected or disconnected. 
* The event parameters are passed via evt_param parameter of the session callback function
* which points to bt_hfp_evt_slc_connection_state_changed_t structure.
*/
#define HFP_EVENT_SLC_CONNECTION_STATE_CHANGED        1	

/**
* This event is reported when audio connection connected or disconnected. 
* The event parameters are passed via evt_param parameter of the session callback function
* which points to bt_hfp_evt_audio_connection_state_changed_t structure.
*/
#define HFP_EVENT_AUDIO_CONNECTION_STATE_CHANGED      2

//#define HFP_EVENT_CMD_RESPONSE_RECEIVED               3

/**
* This event is reported when the AG is notifying the HF about an incoming call. 
* The event has no parameters.
*/
#define HFP_EVENT_RING                                4

/**
* This event is reported when audio data has been received from the AG. 
* The event parameters are passed via evt_param parameter of the session callback function
* which points to bt_hfp_evt_audio_data_t structure.
*/
#define HFP_EVENT_AUDIO_DATA_RECEIVED                 5

/**
* This event is reported if an attempt to connect to the AG has failed.
* The event has no parameters.
*/
#define HFP_EVENT_HEADSET_CONNECT_ATTEMPT_FAILED      6
	
/**
* This event is reported when te AG has changed the microphone gain. 
* The event parameters are passed via evt_param parameter of the session callback function
* which points to bt_hfp_evt_mic_volume_changed_t structure.
*/
#define HFP_EVENT_MIC_VOLUME_CHANGED                  7

/**
* This event is reported when the AG has changed the speaker volume. 
* The event parameters are passed via evt_param parameter of the session callback function
* which points to bt_hfp_evt_spk_volume_changed_t structure.
*/
#define HFP_EVENT_SPK_VOLUME_CHANGED                  8

/**
* This event is reported if an attempt to setup SLC has failed.
* The event has no parameters.
*/
#define HFP_EVENT_SLC_SETUP_ATTEMPT_FAILED            9

/**
* This event is reported when the AG has sent the HF an indicator update. 
* The event parameters are passed via evt_param parameter of the session callback function
* which points to bt_hfp_evt_indicator_received_t structure.
*/
#define HFP_EVENT_INDICATOR_RECEIVED                  10

/**
* This event is reported when the HF has received operator's name. 
* The event parameters are passed via evt_param parameter of the session callback function
* which points to bt_hfp_evt_query_operator_completed_t structure.
*/
#define HFP_EVENT_QUERY_OPERATOR_COMPLETED            11

/**
* This event is reported when the HF has received the number of an incoming call. 
* The event parameters are passed via evt_param parameter of the session callback function
* which points to bt_hfp_evt_clip_received_t structure.
*/
#define HFP_EVENT_CLIP_RECEIVED                       12

/**
* This event is reported when there is a waiting call. 
* The event parameters are passed via evt_param parameter of the session callback function
* which points to bt_hfp_evt_call_waiting_t structure.
*/
#define HFP_EVENT_CALL_WAITING                        13

/**
* This event is reported when the AG has completed executing a command sent to it by the HF. 
* The event parameters are passed via evt_param parameter of the session callback function
* which points to bt_hfp_evt_command_completed_t structure.
*/
#define HFP_EVENT_CMD_COMPLETED                       14

/**
* This event is reported when the AG has changed voice control status. 
* The event parameters are passed via evt_param parameter of the session callback function
* which points to bt_hfp_evt_voice_recognition_changed_t structure.
*/
#define HFP_EVENT_VOICE_RECOGNITION_CHANGED           15

/**
* This event is reported when the HF has received a list of calls from the AG. 
* The event has no parameters.
*/
#define HFP_EVENT_CALL_LIST_RECEIVED                  16

/**
* This event is reported when the AG has changed the status of in-band ringing. 
* The event parameters are passed via evt_param parameter of the session callback function
* which points to bt_hfp_evt_inband_ring_changed_t structure.
*/
#define HFP_EVENT_INBAND_RING_CHANGED                 17

/**
* This event is reported when a call has been connected. 
* The event has no parameters.
*/
#define HFP_EVENT_CALL_STARTED                        18

/**
* This event is reported when active call has ended. 
* The event has no parameters.
*/
#define HFP_EVENT_CALL_ENDED                          19

/**
* This event is reported if an attempt to setup audio connection has failed.
* The event has no parameters.
*/
#define HFP_EVENT_AUDIO_SETUP_ATTEMPT_FAILED          20

/**
* This event is reported when the HF has received a subscriber number from the AG. 
* The event has no parameters.
*/
#define HFP_EVENT_SUBSCRIBER_NUMBER_RECEIVED          21

/**
* This event is reported when the HF has sent a DTMF code to the  AG. 
* The event has no parameters.
*/
#define HFP_EVENT_DTMF_CODE_SENT                      22

/**
* This event is reported when the HF has sent an ATA command to answer incoming call. 
* The event has no parameters.
*/
#define HFP_AG_EVENT_ANSWER_CALL                      23

/**
* This event is reported when the HF has sent an ATA command to reject incoming call
* or to disconnect the call in progress.
* The event has no parameters.
*/
#define HFP_AG_EVENT_TERMINATE_CALL                   24


/**
* This event is reported when the HF has sent a command to originate a call.  Command
* includes dialing a number, dialing from the memory or last number redial.
* The event parameters are passed via evt_param parameter of the session callback function
* which points to bt_hfp_evt_dial_request_received_t structure.
*/
#define HFP_AG_EVENT_DIAL_COMMAND_RECEIVED            25

/**
* This event is reported when HF has sent a command to activate/deactivate voice recognition in AG.
* The event parameters are passed via evt_param parameter of the session callback function
* which points to bt_hfp_evt_activate_voice_recognition_t structure.
*/
#define HFP_AG_EVENT_ACTIVATE_VOICE_RECOGNITION       26

/**
* This event is reported when HF has sent a command to senda DTMF code.
* The event parameters are passed via evt_param parameter of the session callback function
* which points to bt_hfp_evt_dtmf_code_t structure.
*/
#define HFP_AG_EVENT_SEND_DTMF_CODE                   27

/**
* This event is reported when HF has changed the microphone gain. 
* The event parameters are passed via evt_param parameter of the session callback function
* which points to bt_hfp_evt_mic_volume_changed_t structure.
*/
#define HFP_AG_EVENT_MIC_VOLUME_CHANGED               HFP_EVENT_MIC_VOLUME_CHANGED

/**
* This event is reported when HF has changed the speaker volume. 
* The event parameters are passed via evt_param parameter of the session callback function
* which points to bt_hfp_evt_spk_volume_changed_t structure.
*/
#define HFP_AG_EVENT_SPK_VOLUME_CHANGED               HFP_EVENT_SPK_VOLUME_CHANGED

#define HFP_AG_EVENT_SEARCH_COMPLETED                 28

#define HFP_EVENT_AUDIO_PACKET_SENT                   29

#define HFP_AG_EVENT_START_INBAND_RING                30

#define HFP_AG_EVENT_STOP_INBAND_RING                 31

#define HFP_AG_EVENT_HOLD_CALL                        32

#define HFP_AG_EVENT_ACTIVATE_CALL                    33

/**
* This event is reported when NR * EC in the AG has been disabled. 
* This event has no parameters.
*/
#define HFP_EVENT_NREC_DISABLED                        34

#define HFP_HF_FEATURE_EC_NR                    0x00000001
#define HFP_HF_FEATURE_CALL_WAITING             0x00000002
#define HFP_HF_FEATURE_CLI_PRESENTATION         0x00000004
#define HFP_HF_FEATURE_VOICE_RECOGNITTION       0x00000008
#define HFP_HF_FEATURE_REMOTE_VOLUME_CONTROL    0x00000010
#define HFP_HF_FEATURE_ENHANCED_CALL_STATUS     0x00000020
#define HFP_HF_FEATURE_ENHANCED_CALL_CONTROL    0x00000040
#define HFP_HF_FEATURE_CODEC_NEGOTIATION        0x00000080
#define HFP_HF_FEATURE_ALL                      0x000000FF

#define HFP_AG_FEATURE_3_WAY_CALLING				0x00000001
#define HFP_AG_FEATURE_EC_NR						0x00000002
#define HFP_AG_FEATURE_VOICE_RECOGNITTION			0x00000004
#define HFP_AG_FEATURE_INBAND_RING_TONE				0x00000008
#define HFP_AG_FEATURE_ATTACH_NUMBER_TO_VOICE_TAG	0x00000010
#define HFP_AG_FEATURE_REJECT_CALL					0x00000020
#define HFP_AG_FEATURE_ENHANCED_CALL_STATUS			0x00000040
#define HFP_AG_FEATURE_ENHANCED_CALL_CONTROL		0x00000080
#define HFP_AG_FEATURE_EXTENDED_ERROR_CODED			0x00000100
#define HFP_AG_FEATURE_CODEC_NEGOTIATION			0x00000200

#define HFP_HLD_SVC_RELEASE_ALL_HELD_CALLS		0x01
#define HFP_HLD_SVC_RELEASE_ALL_ACTIVE_CALLS	0x02
#define HFP_HLD_SVC_RELEASE_CALL				0x04
#define HFP_HLD_SVC_HOLD_ACTIVE_CALLS			0x08
#define HFP_HLD_SVC_PRIVATE_CALL				0x10
#define HFP_HLD_SVC_ADD_HELD_CALL				0x20
#define HFP_HLD_SVC_EXPLICIT_CALL_TRANSFER		0x40

// Command IDs for the bt_hfp_hf_hold
#define HFP_HLD_CMD_RELEASE_ALL_HELD            0
#define HFP_HLD_CMD_USER_BUSY                   0
#define HFP_HLD_CMD_RELEASE_ALL_ACTIVE_CALLS    1
#define HFP_HLD_CMD_RELEASE_ACTIVE_CALL         1
#define HFP_HLD_CMD_HOLD_ACTIVE_CALLS           2
#define HFP_HLD_CMD_PRIVATE_CALL                2
#define HFP_HLD_CMD_ADD_HELD_CALL               3
#define HFP_HLD_CMD_EXPLICIT_CALL_TRANSFER      4
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
