Samad-Simprints/Vero-Firmware/(commit log)

2015-08-25 Remove ScannerLib and made ArrayList internal to Connector.
2015-12-09 Proper API now implemented in skeleton form, with added Image class and BLE connection. Only a single device per connection, so removed device selection view. Removed Audio Jack connection (at least 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
2015-12-17 Added external memory schematic. Added components to library. Modified top sheet to show hierarchical ports. Added pdf of schematic
    [SCANNER.DSN, SCANNER.OLB, scanner.opj]
2015-12-17 Added sheet for the sensor interface
    [SCANNER.DSN, SCANNER.OLB, scanner.opj]
2015-12-18 Added EMC caps for sending to Secugen
    [UN20B_INTERFACE.DSN, UN20B_interface.opj]
2015-12-18 Rev B
    Modified USB interface for OTG operation
    [SCANNER.DSN, SCANNER.OLB, scanner.opj]
2015-12-21 Revision C
    Added boot mode resistor
    Added BOM
    [Index_BOM.xls, SCANNER.DSN, scanner.opj]
2015-12-21 Updated to include VibroMotor - sent to Microtrax for quoting
    [SCANNER.DSN, SCANNER.OLB, scanner.opj]
2015-12-22 Updated to contain Bi-colour LEDs
    [SCANNER.DSN, SCANNER.OLB, scanner.opj]
2015-12-23 removed unnecessary sheets.
    [Index_BOM.xls]
2015-12-23 Updated with CPU pin assignment feedback
    [SCANNER.DSN, UN20B_INTERFACE.OLB, UN20B_interface.opj, scanner.opj]
2015-12-23 Revision D - review copy
    [Index_BOM.xls, SCANNER.DSN, SCANNER.OLB, scanner.opj]
2015-12-23 Rev E - post review updates
    Addition of footprint information for netlist and BOM:
    - Changed R34 from 0603 to 0805 to reflect part number
    - Changed J4 footprint name to reflect 3 pins
    - Added footprint name to J7 & J8
    - Added supplier and manufacturer numbers to L3,L4,L6,L9
    - Added footprint names to U8 & U9
    - Added footprint names to J2 & J3
    Updated BOM and schematic
    [Index_BOM.xls, SCANNER.DSN, scanner.opj]
2015-12-24 Tidy up and USB boot support
    [scanner.opj]
2015-12-24 Rev. F
    Added power up/down circuitry:
    - R77-R81
    - C57&C58
    - D15 & D16
    - Q4
    Depressing button 0 will enable 3.3V regulator and boot processor, the processor will then hold nPWR_DOWN high to keep regulator active.
    Depressing button 0 for a second time will activate an interrupt allowing the processor an orderly shutdown.
    Holding button 0 will cause an immediate shutdown after approx. 10 seconds.
    [Index_BOM.xls, SCANNER.DSN, SCANNER.OLB, scanner.opj]
2015-12-24 Rev. G
    Changed C57 to 100nF
    Corrected symbol for BSS138
    Corrected net name POWER_DOWN_IRQ
    [Index_BOM.xls, SCANNER.DSN, SCANNER.OLB, scanner.opj]
2016-01-04 Revision H
    Changed D1 to blue LED and value of R1 to 120R
    Changed USB1_VBUS to USB1_PPWR
    Added U10 single gate inverter to nUSB0_PWR_FLT signal
    Modified SRAM memory address lines for 16 bit interface
    [Index_BOM.xls, SCANNER.DSN, SCANNER.OLB, scanner.opj]
2016-01-04 Updated to include VCC_USB generator
    [UN20B_INTERFACE.DSN, UN20B_INTERFACE.OLB, UN20B_interface.opj]
2016-01-12 Changed S1,S2 to J leg version
    [Index_BOM.xls, SCANNER.DSN, SCANNER.OLB, scanner.opj]
2016-01-27 Rev J: J4 to RA part and Vib to NF
    [SCANNER.DSN, SCANNER.OLB, scanner.opj]
2016-01-27 Revision A - manufacturing files
    Microtrax files: Fen-Tech_Scanner-Index_vA_Finished_13--Jan
    [layout.pcb]
2016-01-29 Initial checkin of Index code. Will boot and run initial version of LPC app. Can run Bluetooth speedtest application from Searan Has USB library code included but is not currently built
2016-02-02 Adding changes to get USB stack building within CrossWorks - something of a hatchet job due to two sets of abstraction layer code - Code does enumerate on both ports - Code does not currently transfe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
    [CDC.c, CDC.h, CDCDescriptors.c, CDCDescriptors.h, DualDevice.c, HAL_LPC18xx.c, HAL_LPC18xx.h, app_main.cpp]
2016-02-03 Adding minimal set of files required to get LPCUSB library to build On latest revision of boards - Power off now work - Interrupts work - both are now falling edge - USB reprogramming comes up if ext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
2016-02-03 Add MSG_IAMGE_QUALITY to bMsgId enums. Add bool boPowerOn to MsgUN20Info struct. Fix a couple of comment typos.
    [msg_format.h]
2016-02-05 Multi-device CDC descriptors.
2016-02-05 Board bring up tests and snag list
    [Index_TestCoverage.xlsx]
2016-02-09 Retrieves UN20 device descriptor. Spews chars to USB Host.
2016-02-09 Connector callback added. Connector Listener defined but not used. Message handling much improved. DemoConnection fakes get sensor info. BtConnection talks to SSP device. Application close scanner co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
2016-02-10 Generate the USB1 60MHz clock using dividers from the USB0 480MHz clock Minor pin definition changes Fix bug in gpio/pin lookup table that affected the UN20 serial port Tidy up lpcapp.c now it has be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
    [DualDevice.c, HAL_LPC18xx.c, app_main.cpp, gpio_dd.cpp, gpio_pindefs.hpp, hal.cpp, lpcapp.c]
2016-02-11 Bluetooth now connecting and exchanging messages. LEDs flashing, battery level read (incorrectly).
2016-02-11 First bidirectional communication over Bluetooth - SetUi and GetSensor information executed from Fen's own test application Add UN20 application sources and make files. - Currently being built using 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
    gi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
    [app_main.cpp, global.h, hal.cpp, hal.h, lpcapp.c, main.cpp, msg_format.h, protocol_msg.c]
2016-02-12 Fixed bug in vIncomingBytes for single-byte inputs.
    [msg_format.h, proj_defs.h, protocol_msg.c]
2016-02-12 Get the UN20 app driving the SDK - Initialisation - Image capture - Quality report - Template generation - Results not yet exported from the phone Work on serial comms to UN20 for message transfer - 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
2016-02-12 Doesn't request UN20-info except after power-on. Flashes LEDs at start-up.
    [lpcapp.c]
2016-02-13 Fix bug in lpcapp when processing UN20 shutdown message (shutdown flag set too early) Complete power up and power down sequence - New InitScript prepares system ans starts the UN20 server app at powe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
    [app_main.cpp, global.h, hal.cpp, lpcapp.c, main.cpp]
2016-02-17 Flushing development into svn Have disabled startup LED smile as its breaking the BT stack by side effect. This is likely an indication of thread startup synchronisation issues that we need to addres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
    [compress.c, lpcapp.c, main.cpp, msg_format.h]
2016-02-18 Reset packet assembler for a source when its interface goes up or down Create some utility functions for creating ACK and NACK responses un20app returns a response for all messages received Restore c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
    [lpcapp.c, main.cpp, msg_format.h, protocol_msg.c, protocol_msg.h]
2016-02-19 HAL creates UN20 USB interface up and down events when UN20 power is turned on/off - should be driven from USB enumeration but done here while using serial interface Turn on WFI in RTOS idle callback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
    [app_main.cpp, hal.cpp, helpers.cpp, lpcapp.c, lpcapp.h, main.cpp]
2016-02-22 Partial fix for include filename case sensitivity to ease building on Linux - Note this has resulted in changing some files that are part of the CMSIS distribution
    [adc_dd.cpp, app_main.cpp, cmsis.h, global.h, gpio_dd.cpp, hal.cpp, haltest.c, helpers.cpp]
2016-02-22 Recovering from SVN snafu where stuff failed to make it into the repository
    [lpcapp.h, msg_format.h, protocol_msg.h]
2016-02-22 More case sensitivity fix ups
    [lpc18xx_can.c]
2016-02-24 Flushing work in progress. - Removed LED flash and vibrate tasks. Now driven just by timers (which are driven by the timer task) - Handle buttons in interrupt safe way. Post internal messages to be h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
    [adc_dd.cpp, adc_dd.hpp, global.h, gpio_dd.cpp, gpio_dd.hpp, gpio_pindefs.hpp, hal.cpp, lpcapp.c]
2016-02-29 Get battery level monitoring wired up. - LED flashes when voltage falls below threshold - Board powers off (including shutting down UN20), below min battery voltage Reorder the ADC to voltage calcula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
    [adc_dd.cpp, hal.cpp, lpcapp.c]
2016-03-01 UN20 App - Remove C variant code - Enable compression after capture (relies on replacement libm.so) - Increase baud rate to 115200 - Modify deploy, install and start process to update new libm.so - i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
    [adc_dd.cpp, hal.cpp, main.cpp]
2016-03-04 Development snapshot: Added delays to USB start-up code. USB enumeration and descriptor fetching works on Debug and Release but we don't know why yet. Delays need removing or tuning. USB init comment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
    [DualDevice.c, HAL_LPC18xx.c, app_main.cpp]
2016-03-09 Drop the main CPU clock to reduce power consumption Up serial link to 230400 Instrument sleep code by toggling two spare GPIO's lpcapp.c - Add battery reading averaging - Clean up the way the UN20 id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
    [HAL_LPC18xx.c, app_main.cpp, hal.cpp, helpers.cpp, lpcapp.c, main.cpp, msg_format.h, proj_defs.h]
2016-03-10 hal.cpp - code cleanup lpcapp.c - Add debug zones for output control - On power off don't shutdown the UN20 if it is already shutdown (or on its way down) main.cpp - Allow debug output to be controll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
2016-04-25 Initial Phase 2 work check-in Scanner - Some cleanup (cpp support) - Add general watchdog and trap support. Creates a crash log record that is recovered on reset and stored for later delivery - Provi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
    [adc_dd.hpp, app_main.cpp, cli.h, cppsupport.cpp, crc.c, crc.h, dbgapi.h, exception.c]
2016-04-26 Include path case sensitivity issues resolved for Linux builds
2016-04-26 Include file case sensitivity for Linux build
2016-05-05 First draft of UN20EX interface schematic for review
    [UN20EX1_INTERFACE.DSN, un20ex1_interface.opj]
2016-05-10 Start of Rev B updates
    [SCANNER_REVB.DSN, scanner_revb.opj]
2016-05-11 Pairing - Change the friendly name to use decimal digits only - Use Sector 2 in Bank B to store the link keys Commands - Add support for crash log recovery - Add support for hardware reconfiguration 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
    [app_main.cpp, exception.c, exception.h, gpio_pindefs.hpp, hal.cpp, hal.h, lpcapp.c, msg_format.h]
2016-05-12 Fixing crash in release build caused by data going out of scope (dotstack function not taking copy of data passed) Leave debug output enabled in release builds (Note: default debug zones DO change in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
    [app_main.cpp, helpers.cpp]
2016-05-12 continuing rev b updates
    [SCANNER_REVB.DSN, scanner_revb.opj]
2016-05-16 Updated to remove hardware battery LED control
    [SCANNER.OLB, SCANNER_REVB.DSN, scanner_revb.opj]
2016-05-20 updated with footprint codes from Neil
    [SCANNER.OLB, SCANNER_REVB.DSN, scanner_revb.opj]
2016-05-25 Updated to include MS review comments and added gas gauge
    [SCANNER.OLB, SCANNER_REVB.DSN, scanner_revb.opj]
2016-05-31 Updated to include test fixture test points and sprunhg loaded JTAG probe
    [SCANNER.OLB, SCANNER_REVB.DSN, scanner_revb.opj]
2016-06-08 Rev B build release
    [SCANNER_REVB.DSN, scanner_revB.xlsx, scanner_revb.opj]
2016-06-08 Change default MAC address to a valid SimPrints MAC address Fix friendly name generation from the MAC address UN20EX1 changes - InitScript - add possibility of starting ftp server (off by default) - 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
    [app_main.cpp, main.cpp]
2016-06-29 updated to revision B:
    Files updated and name changed:
    File name: SPN00093-RevB-Gerber.zip renamed Fen_Tech_Scanner_Index_Gerber.zip
    File name: SPN00093-RevB-01-06-16.pcb renamed layout.pcb
    added file: SPN00093-RevB-01-06-16.tgz - mechanical model and assembly archive
    [layout.pcb]
2016-07-06 Add test coverage spreadsheet for Rev B
    [Index_TestCoverageRevB.xlsx]
2016-07-07 update mod list
    [Index_TestCoverageRevB.xlsx]
2016-07-08 Changes for revision 2 main scanner PCB - new SFS board power control - reduce number of LEDS and restrict those the app can control to the smile LED's only - minor code changes to reflect the way th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
    [gpio_pindefs.hpp, hal.cpp, hal.h, haltest.c, lpcapp.c, msg_format.h, proj_defs.h, test_msgs.c]
2016-07-08 Revision C manufacturing information:
    Microtrax files:
    - layout.pcb from 3039_Fen-Tech_SPN00093_vC_FINISHED_8-Ju.pcb
    - Fen_Tech_Scanner_Index_Gerber.zip from SPN00093_vC_GERBER_8-Ju.zip
    - updated Fen_Tech_Scanner_Index_Assy.zip
    - Scanner-Index_Btm_Assy.pdf from SPN00093_vC_Assy-Bottom_8-Jul.pdf
    - Scanner-Index_Top_Assy.pdf from SPN00093_vC_Assy-Top_8-Jul.pdf
    - added ODB
    - added scanner.asc from SPN00093_vC_ASCII_8-Jul.asc
    [layout.pcb]
2016-07-11 Updated mod list
    [Index_TestCoverageRevB.xlsx]
2016-07-25 Add Main PCB release binary
2016-07-25 Main PCB install: integrate into main repro and save out qr code
2016-07-27 Main PCB install: add batch wrapper
2016-08-01 (Probably fixed the unwanted restart + added led shutdown sequence
    [hal.cpp, lpcapp.c, watchdog_dd.c, watchdog_dd.h]
2016-08-02 Rev C schematic
2016-08-02 Rev C OrCad files:
    Changes from rev B:
    - SW1.3 now connected to U5.7
    - U5.5 now connected to Q9 via two diodes D18 and D19
    - Replaced R77 with D16
    - Added D17
    - Changed D15 type
    - U9.3 now connected to C57
    [SCANNER.OLB, SCANNER_REVC.DSN, UN20B_interface.opj, scanner_revc.opj]
2016-08-02 Quick fix to prevent the scanner's battery to get flat overnight if the power goes down
    [lpcapp.c]
2016-08-03 Revert "Quick fix v2"
    This reverts commit 0e4174e7e85782db5f6c61737365bcb679d7fcd7.
    [app_main.cpp, lpcapp.c, lpcapp.h]
2016-08-03 Revert "Quick fix to prevent the scanner's battery to get flat overnight if the power goes down"
    This reverts commit efc72e5d3457171c35471981c3d1cf13d6e3f026.
    [lpcapp.c]
2016-08-04 Main pcb automated versioning
2016-08-04 Stop dotstack using LED's for fatal error and UI reporting. - Use a callback that triggers an assert instead for fatal errors - We dont need any UI support so just comment that out Add support for mo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
    [app_main.cpp, lpcapp.c, lpcapp.h, msg_format.h, proj_defs.h]
2016-08-04 Add shut down LED dance to charging->shutdown
2016-08-05 Shutdown sequence not appearing after 1st shutdown while charging fixed
    [lpcapp.c]
2016-08-05 Shutdown led not needed on charging (while off)
2016-08-09 Add debounce of power and scan buttons to dodge spurious notifications which are coming from somewhere on the board. If the button is no longer pressed after 2 successive sample periods ignore the no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
    [app_main.cpp, hal.cpp, hal.h, lpcapp.c]
2016-08-09 Root cause of long period turn on/off found to be the inactivity timer not being aware of the new charging mode. Quick fix to get SimPrints moving. Requires review of timer management w.r.t. charging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
    [lpcapp.c]
2016-12-08 Pass all UN20 get image errors to phone
    [main.cpp, msg_format.h]
2016-12-14 Expose finger check enable#disable to outside world
2016-12-15 Correct logic in set finger check return
    [main.cpp]
